D3stan/ecu-dev-board/emulator/docs/image.png

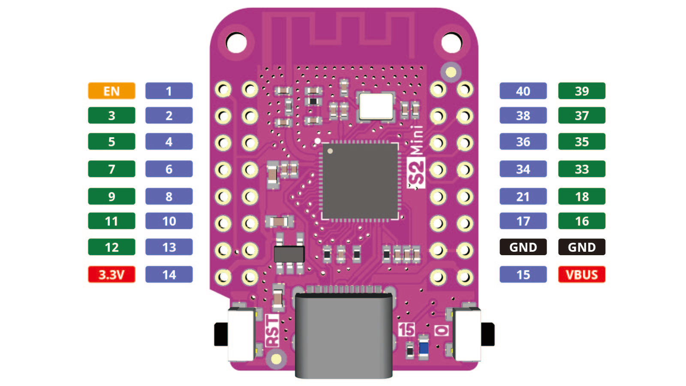
emulator/docs/image.png
