D3stan/ecu-dev-board/emulator/docs/architecture.md

# Simulator Node High-Level Architecture Prototyping

This document outlines the high-level architecture of the **ECU Simulator Node**. The simulator runs on a secondary ESP32 development board (e.g., standard ESP32 or ESP32-S2), serving as a hardware-in-the-loop (HIL) test-bench. It physicalizes mechanical and thermal signals (Pick-up coil sensor, Throttle Position Sensor, Exhaust Gas Temperature) and measures the resulting ECU CDI (Capacitor Discharge Ignition) trigger output to calculate spark advance.

## Design Philosophy: Centralized Configuration & Native ESP-IDF

To ensure sub-microsecond pulse timing accuracy, zero task-switching overhead, and maximal determinism in the kinematics calculations, **the core Simulator logic operates in a single-threaded superloop** paired with hardware interrupts and low-overhead timers. 

### Key Principles:
- **Centralized Pin Mappings**: All simulator inputs and outputs are defined as macros in a centralized `pins.h` header file, allowing easy hardware portability across ESP32 and ESP32-S2 development boards.
- **ESP-IDF Native Components**: Web interfaces and API endpoints are powered by ESP-IDF's native `esp_http_server` module, avoiding third-party Arduino dependencies and maintaining compliance with standard ESP-IDF workflows.
- **Analog Sensor Outputs**: EGT is generated with the on-chip DAC. On the LOLIN ESP32-S2 mini, TPS is generated with LEDC PWM on GPIO16 and an external RC low-pass filter because GPIO18/DAC_2 is pulled up on the board.
- **Open-Loop Signal Generation**: The pick-up coil pulse generator operates independently of the ECU's spark output, dynamically translating the selected RPM (from Web UI or potentiometer) to a corresponding frequency in Hz.
- **Passive Monitoring**: The spark advance capture system acts as a passive observer, measuring the phase relationship of the ECU's output relative to the generated pickup signal without feeding back into the signal generation logic.

---

## High-Level Architecture Overview

The simulator consists of three key architectural blocks cooperating in a single-threaded loop:

```mermaid
graph TD
    subgraph MCU Core [MCU Core & State Machine]
        Superloop[Superloop Main Timing Loop]
        EngineSim[Engine Kinematics & Thermal Simulator]
        Telemetry[JSON Frame Composer]
    end

    subgraph IO [I/O - Signal Generators & Capture]
        ADC_Read[ADC: Read TPS & EGT Potentiometers]
        PulseGen[Hardware Timer: Pick-up Pulse Generator]
        SparkCapture[GPIO Interrupt: Spark Timing Capture]
        QSButton[GPIO Poll: Physical QS Button]
    end

    subgraph WebUI [Simulator Web UI & API]
        HTTPServer[esp_http_server - Native Web & WS]
        OverrideMgr[Manual Override / Fault Injector]
    end

    Superloop -->|Run Periodic| EngineSim
    Superloop -->|Process Polls| ADC_Read
    EngineSim -->|Compute Target Freq| PulseGen
    SparkCapture -->|Record Spark Offset| EngineSim
    QSButton -->|Trigger QS Pulse| EngineSim
    HTTPServer -->|Inject Overrides| OverrideMgr
    OverrideMgr -->|Override Params| EngineSim
    EngineSim -->|State Payload| Telemetry
    Telemetry -->|Stream via Websockets| HTTPServer
```

---

## Important Subsystems

To keep the codebase modular and organized, the architecture is split into three main technical specifications:

### 1. [MCU Core (Engine Simulator)](file:///Users/puddu/Documents/GitHub/ecu-dev-board/idf/docs/sim/mcu_core.md)
Responsible for engine rotation kinematics, thermal rise/decay equations, virtual overrides, and telemetry compilation. It coordinates the overall logic of the simulation without spawning concurrent tasks.

### 2. [I/O Interface (Hardware Layer)](file:///Users/puddu/Documents/GitHub/ecu-dev-board/idf/docs/sim/io.md)
Responsible for physical interaction, using pin assignments defined in `pins.h`:
- **Generation**: Creating the pick-up sensor square wave based on the selected RPM using hardware LEDC.
- **Measurement**: Capturing the ECU's CDI spark output with a high-precision input capture GPIO interrupt.
- **Sampling**: Reading physical potentiometers using the ADC to simulate TPS and EGT sensors.

### 3. [Simulator Web UI (Interactive Panel)](file:///Users/puddu/Documents/GitHub/ecu-dev-board/idf/docs/sim/web_ui.md)
A lightweight web interface hosted directly on the simulator's flash filesystem. It allows developers to:
- Actively override analog sensor values (TPS, EGT) via virtual sliders.
- Artificially inject faults (e.g., EGT overheating) to test the ECU's `ALARM` state.
- Monitor physical spark timing metrics calculated by the capture system.

---

## HIL Hardware Connections

All pins listed below are configurable via `pins.h` to support various development boards (ESP32 / ESP32-S2):

| Simulator Pin Macro | ESP32-S2 / Lolin S2 Mini GPIO | Signal Type | Signal Description |
|---|---|---|---|
| `SIM_PIN_PICKUP` | **GPIO 13** | Output to ECU | Pick-up Coil Pulse (0-300 Hz square wave) |
| `SIM_PIN_TPS_OUT` | **GPIO 16** | Output to ECU | TPS PWM output; filter through 1k + 4.7uF before ECU TPS input |
| `SIM_PIN_EGT_OUT` | **GPIO 17** | Output to ECU | EGT Analog Voltage (0-3.3V via hardware DAC Channel 1) |
| `SIM_PIN_SPARK` | **GPIO 21** | Input from ECU | CDI Ignition Spark Trigger |
| `SIM_PIN_QS_OUT` | **GPIO 12** | Output to ECU | Quick-Shifter (QS) Switch Trigger (Active-Low pulse) |
| `SIM_PIN_QS_IN` | **GPIO 14** | Local input | Physical active-low QS button input; debounced in the fast superloop poll |
| `SIM_PIN_TPS_POT` | **GPIO 1** | Local analog input | Physical TPS potentiometer (ADC1_CH0) |
| `SIM_PIN_EGT_POT` | **GPIO 2** | Local analog input | Physical EGT potentiometer (ADC1_CH1) |
| **GND** | **GND** | Ground Share | Common Ground Reference |
