D3stan/ecu-dev-board/emulator/webui/doc/useComponents/InputTimer/INDEX.md

# 📁 InputTimer Component - Documentazione

Questo folder contiene tutta la documentazione e gli esempi d'uso per il componente **InputTimer**.

---

## 📂 Struttura

```
InputTimer/
├── INDEX.md           # Questo file (indice documentazione)
├── README.md          # Documentazione tecnica completa del componente
├── SETUP.md           # Guida setup e integrazione passo-passo
├── example.js         # 5 esempi pratici di utilizzo
└── func.test.js       # Unit tests per le funzioni di utilità
```

---

## 🚀 Quick Start

1. **Setup**: Leggi [`SETUP.md`](./SETUP.md) per la guida passo-passo
2. **Documentazione**: Consulta [`README.md`](./README.md) per l'API completa
3. **Esempi**: Vedi [`example.js`](./example.js) per 5 casi d'uso pratici
4. **Test**: Esegui [`func.test.js`](./func.test.js) per testare la logica

---

## 📦 File di Produzione

I file di produzione si trovano in:

```
src/
├── js/components/InputTimer/
│   ├── InputTimer.js    ✅ Componente (extends Component)
│   └── func.js          ✅ Logica di conversione/validazione
│
└── css/components/
    └── InputTimer.css   ✅ Stili responsive
```

**Nota**: Solo questi 3 file vengono inclusi nel build di Vite. La documentazione resta fuori da `src/`.

---

## 🎯 Stato Implementazione

✅ **Completato** (18 Ottobre 2025)

- [x] Componente InputTimer creato
- [x] Logica separata in func.js
- [x] CSS responsive mobile-first
- [x] Traduzioni i18n (5 lingue)
- [x] Integrato in TimerEditorPage
- [x] CSS incluso in index.html
- [x] Build Vite funzionante
- [x] Documentazione completa
- [x] Esempi d'uso
- [x] Unit tests

---

## 📖 Link Utili

- [API Completa](./README.md#-api)
- [Esempi d'uso](./example.js)
- [Setup Checklist](./SETUP.md#-checklist-finale)
- [Troubleshooting](./README.md#-troubleshooting)
- [Testing](./README.md#-testing-checklist)

---

**Versione**: 1.0.0  
**Autore**: FogExtra Team  
**Data**: 18 Ottobre 2025
