D3stan/ecu-dev-board/pcb/Enclosure.step

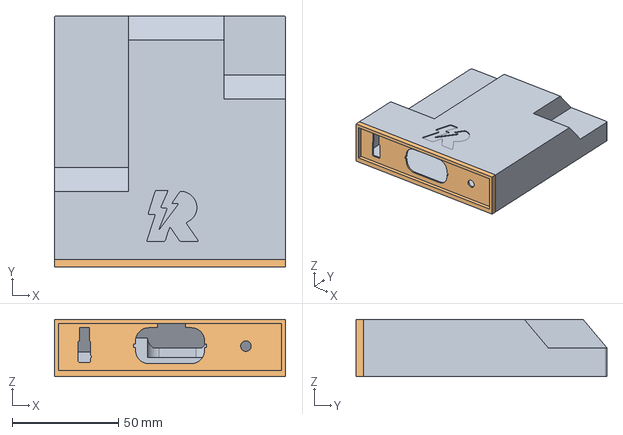
[picture p2: CAD file, 2025-12-03]
pcb/Enclosure.step
108.9 x 118.1 x 27.0 mm
