D3stan/ecu-dev-board/pcb/ecu-dev-board.kicad_pcb

## KiCad design pcb/ecu-dev-board.kicad_pcb (2025-10-15)

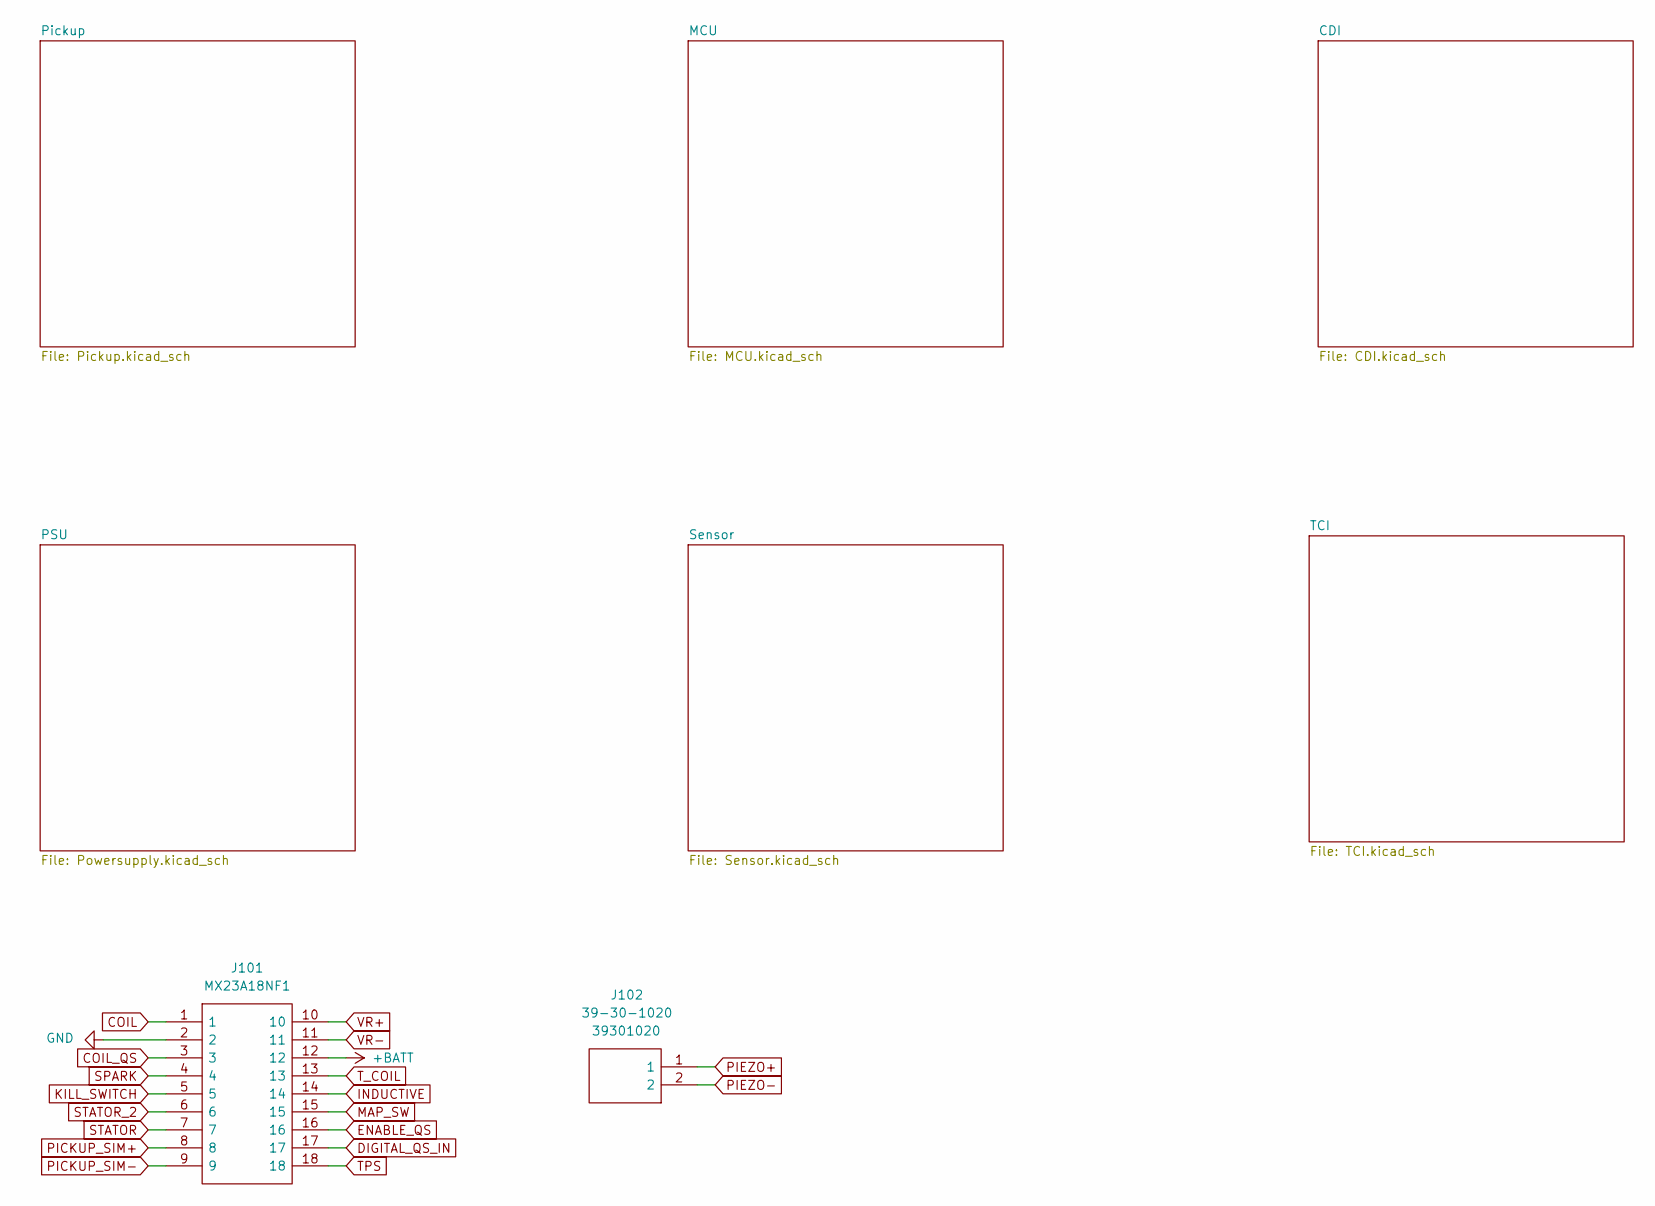
[picture p3: schematic ecu-dev-board.kicad_sch]

Parts:
J101: MX23A18NF1; Manufacturer_Part_Number MX23A18NF1; Mouser Part Number 656-MX23A18NF1
J102: 39-30-1020; Molex_Mini-Fit_Jr_5569-02A2_2x01_P4.20mm_Horizontal; Manufacturer_Part_Number 39301020; Mouser Part Number 538-39-30-1020

Connections:
+BATT: J101.12; also elsewhere on the board
COIL: J101.1; also elsewhere on the board
COIL_QS: J101.3; also elsewhere on the board
DIGITAL_QS_IN: J101.17; also elsewhere on the board
ENABLE_QS: J101.16; also elsewhere on the board
INDUCTIVE: J101.14; also elsewhere on the board
KILL_SWITCH: J101.5; also elsewhere on the board
MAP_SW: J101.15; also elsewhere on the board
PICKUP_SIM+: J101.8; also elsewhere on the board
PICKUP_SIM-: J101.9; also elsewhere on the board
PIEZO+: J102.1; also elsewhere on the board
PIEZO-: J102.2; also elsewhere on the board
SPARK: J101.4; also elsewhere on the board
STATOR: J101.7; also elsewhere on the board
STATOR_2: J101.6; also elsewhere on the board
TPS: J101.18; also elsewhere on the board
T_COIL: J101.13; also elsewhere on the board
VR+: J101.10; also elsewhere on the board
VR-: J101.11; also elsewhere on the board

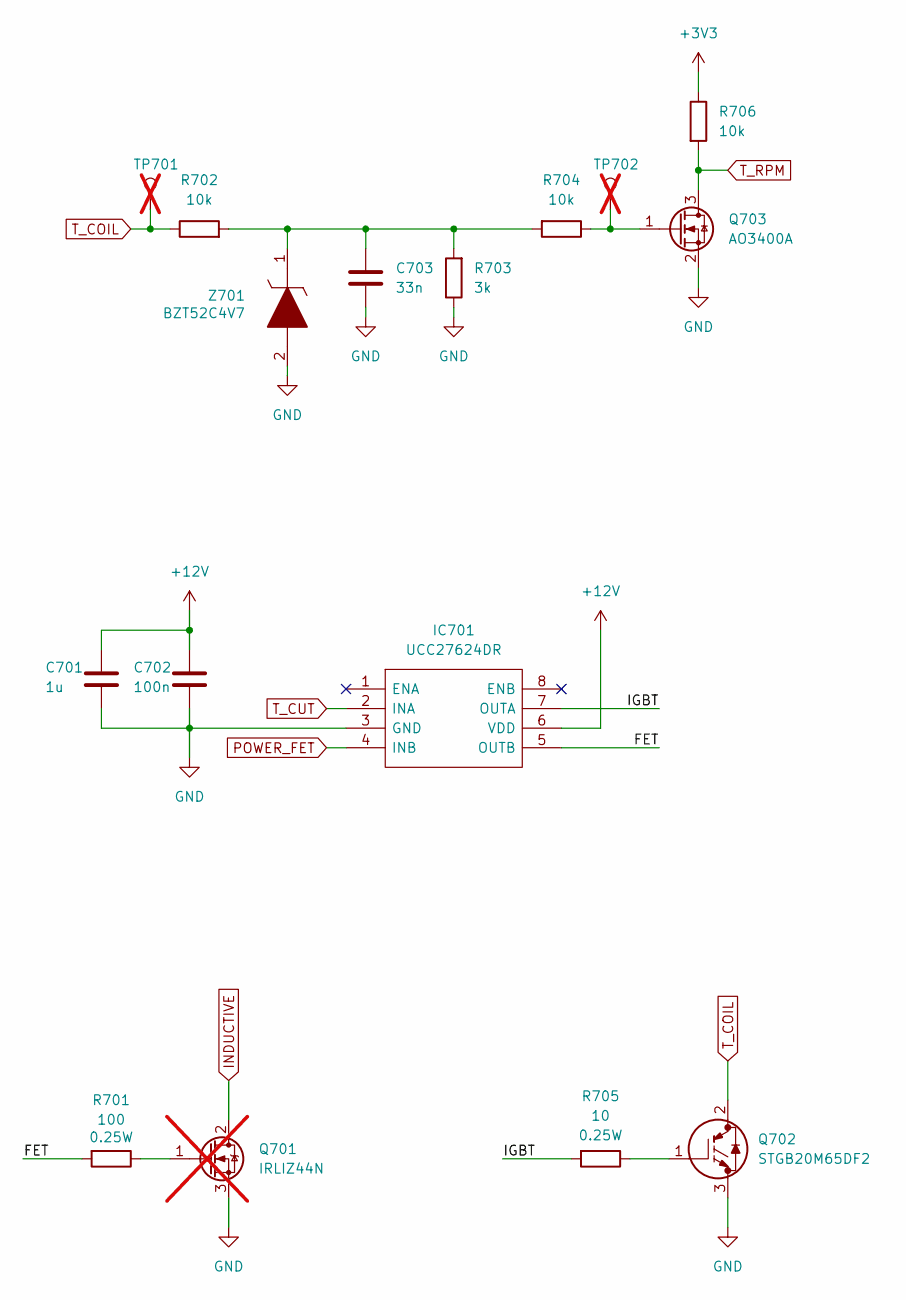
[picture p4: schematic TCI.kicad_sch]

Parts:
C701: 1u; C_0805_2012Metric
C702: 100n; C_0805_2012Metric
C703: 33n; C_0805_2012Metric
IC701: UCC27624DR; SOIC127P600X175-8N; Manufacturer_Part_Number UCC27624QDRQ1; Mouser Part Number 595-UCC27624QDRQ1
Q701: IRLIZ44N; TO-220F-3_Vertical; not fitted
Q702: STGB20M65DF2; TO-263-2; Manufacturer_Part_Number STGB20M65DF2; Mouser Part Number 511-STGB20M65DF2
Q703: AO3400A; SOT-23
R701: 100; R_0805_2012Metric
R702, R704, R706: 10k; R_0805_2012Metric
R703: 3k; R_0805_2012Metric
R705: 10; R_0805_2012Metric
TP701, TP702: TestPoint; PinHeader_1x01_P2.54mm_Vertical; not fitted
Z701: BZT52C4V7; D_SOD-123; Manufacturer_Part_Number BZT52B5V1-E3-08; Mouser Part Number 78-BZT52B5V1-E3-08

Connections:
+3V3: R706.1; also elsewhere on the board
+12V: C701.1, C702.1, IC701.6 (VDD); also elsewhere on the board
/TCI/FET: IC701.5 (OUTB), R701.2
/TCI/IGBT: IC701.7 (OUTA), R705.2
INDUCTIVE: Q701.2 (D); also elsewhere on the board
unnamed: C703.1, R702.2, R703.2, R704.2, Z701.1
unnamed: Q701.1 (G), R701.1
unnamed: Q702.1, R705.1
unnamed: Q703.1 (G), R704.1, TP702.1
POWER_FET: IC701.4 (INB); also elsewhere on the board
T_COIL: Q702.2, R702.1, TP701.1; also elsewhere on the board
T_CUT: IC701.2 (INA); also elsewhere on the board
T_RPM: Q703.3 (D), R706.2; also elsewhere on the board

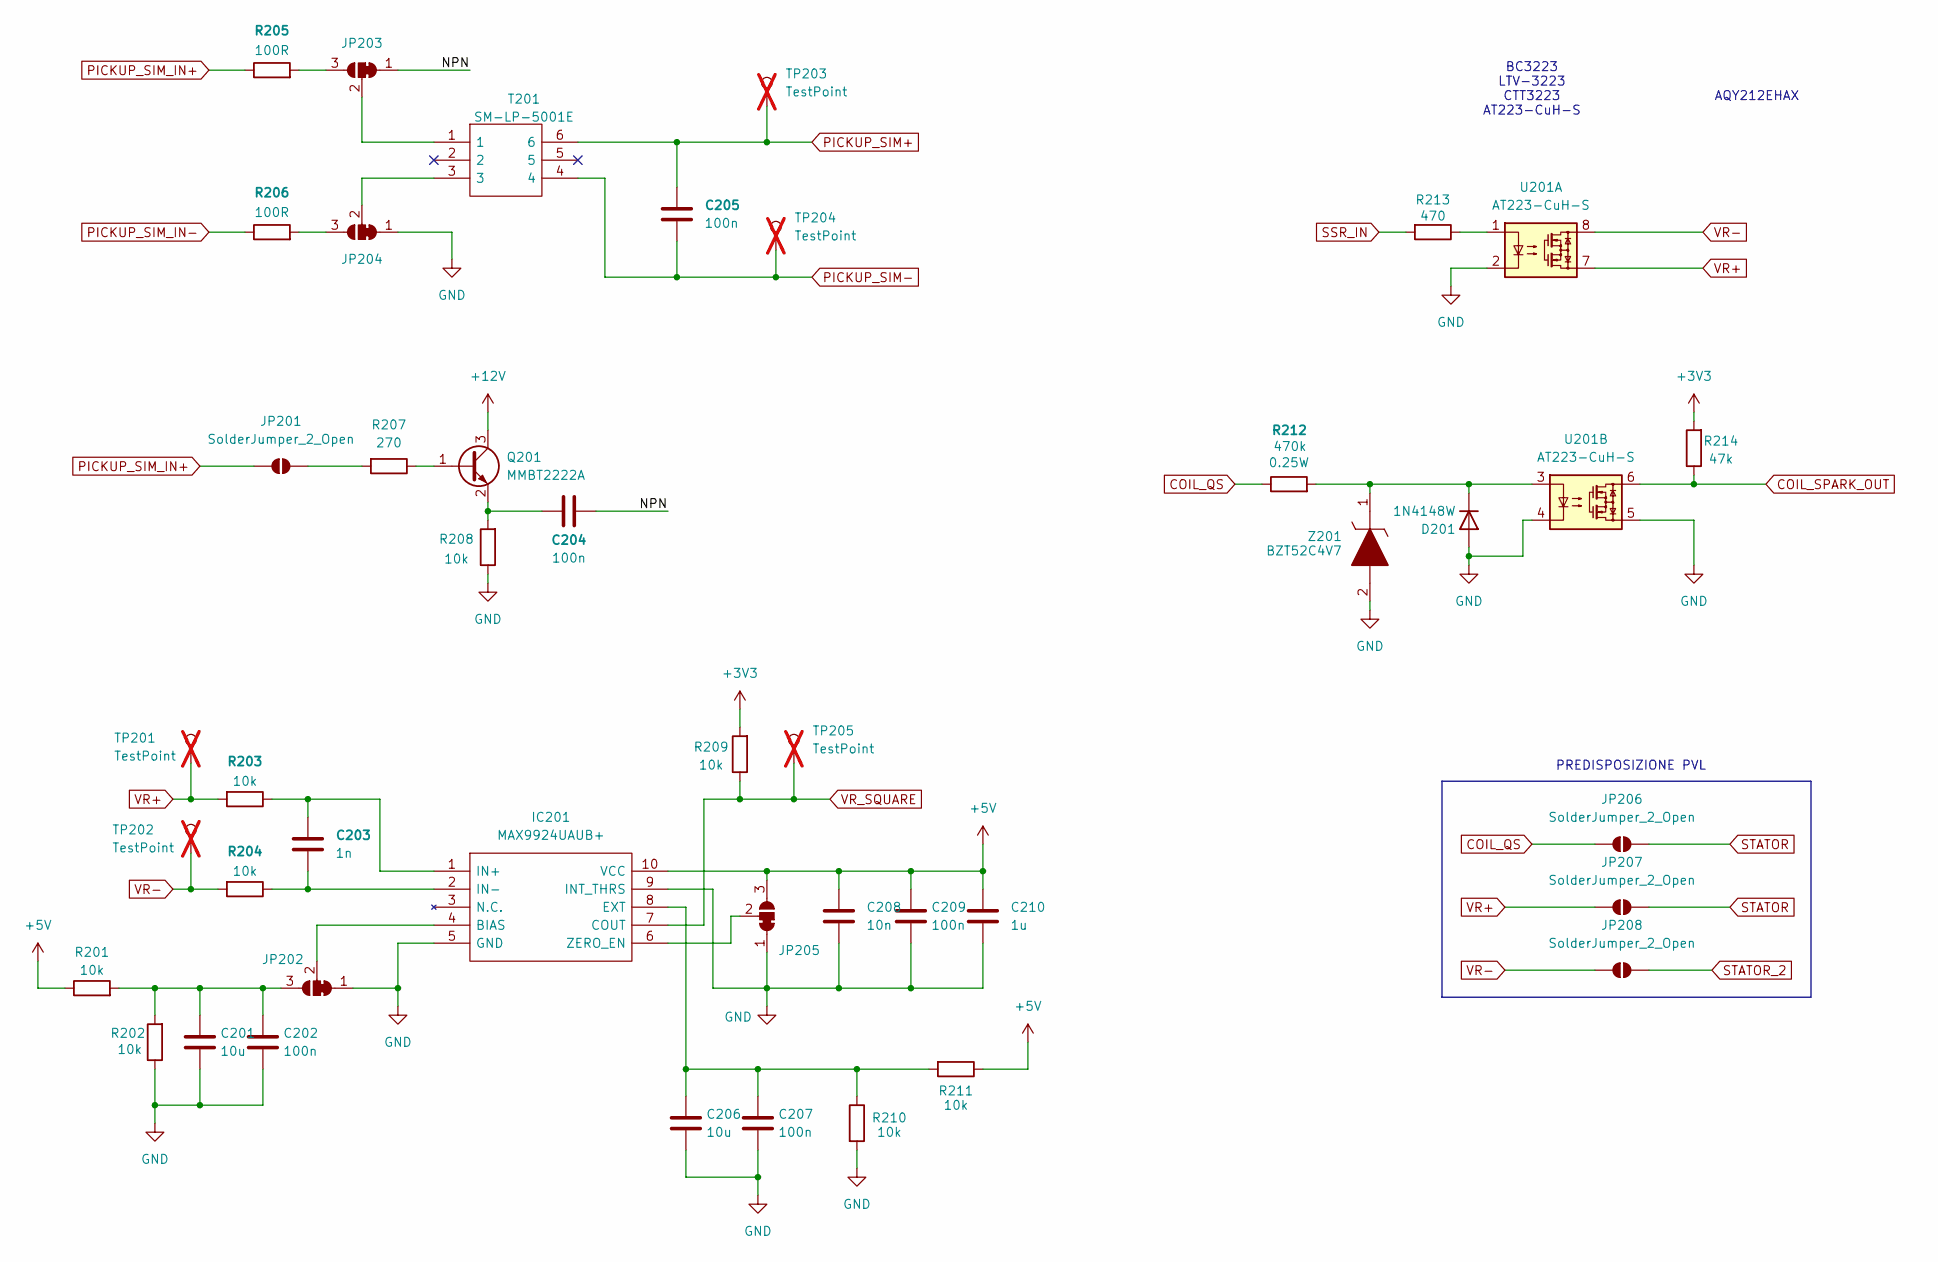
[picture p5: schematic Pickup.kicad_sch]

Parts:
C201, C206: 10u; C_0805_2012Metric
C202, C204, C205, C207, C209: 100n; C_0805_2012Metric
C203: 1n; C_0805_2012Metric
C208: 10n; C_0805_2012Metric
C210: 1u; C_0805_2012Metric
D201: 1N4148W; D_SOD-123
IC201: MAX9924UAUB+; SOP50P490X110-10N; Manufacturer_Part_Number MAX9924UAUB+; Mouser Part Number 700-MAX9924UAUB
JP201, JP206, JP207, JP208: SolderJumper_2_Open; SolderJumper-2_P1.3mm_Open_RoundedPad1.0x1.5mm
JP202, JP203, JP204, JP205: SolderJumper_3_Bridged12; SolderJumper-3_P1.3mm_Bridged2Bar12_RoundedPad1.0x1.5mm
Q201: MMBT2222A; SOT-23
R201, R202, R203, R204, R208, R209, R210, R211: 10k; R_0805_2012Metric
R205, R206: 100R; R_0805_2012Metric
R207: 270; R_0603_1608Metric
R212: 470k; R_0805_2012Metric
R213: 470; R_0805_2012Metric
R214: 47k; R_0805_2012Metric
T201: SM-LP-5001E; SMLP5001E; Manufacturer_Part_Number SM-LP-5001E; Mouser Part Number 652-SM-LP-5001E
TP201, TP202, TP203, TP204, TP205: TestPoint; PinHeader_1x01_P2.54mm_Vertical; not fitted
U201: AT223-CuH-S; SOP-8_6.605x9.655mm_P2.54mm
Z201: BZT52C4V7; D_SOD-123; Manufacturer_Part_Number BZT52B5V1-E3-08; Mouser Part Number 78-BZT52B5V1-E3-08

Connections:
+3V3: R209.2, R214.2; also elsewhere on the board
+5V: C208.1, C209.1, C210.1, IC201.10 (VCC), JP205.3 (B), R201.1, R211.1; also elsewhere on the board
+12V: Q201.3 (C); also elsewhere on the board
/Pickup/NPN: C204.1, JP203.1 (A)
COIL_QS: JP206.2 (B), R212.1; also elsewhere on the board
COIL_SPARK_OUT: R214.1, U201.6; also elsewhere on the board
unnamed: D201.1 (K), R212.2, U201.3, Z201.1
unnamed: IC201.4 (BIAS), JP202.2 (C)
unnamed: C206.1, C207.1, IC201.8 (EXT), R210.1, R211.2
unnamed: C203.1, IC201.1 (IN+), R203.1
unnamed: C203.2, IC201.2 (IN-), R204.1
unnamed: IC201.6 (ZERO_EN), JP205.2 (C)
unnamed: JP201.1 (A), R207.2
unnamed: C201.1, C202.1, JP202.3 (B), R201.2, R202.2
unnamed: JP203.3 (B), R205.2
unnamed: JP203.2 (C), T201.1
unnamed: JP204.3 (B), R206.2
unnamed: JP204.2 (C), T201.3
unnamed: Q201.1 (B), R207.1
unnamed: C204.2, Q201.2 (E), R208.2
unnamed: R213.1, U201.1
PICKUP_SIM+: C205.1, T201.6, TP203.1; also elsewhere on the board
PICKUP_SIM-: C205.2, T201.4, TP204.1; also elsewhere on the board
PICKUP_SIM_IN+: JP201.2 (B), R205.1; also elsewhere on the board
PICKUP_SIM_IN-: R206.1; also elsewhere on the board
SSR_IN: R213.2; also elsewhere on the board
STATOR: JP206.1 (A), JP207.1 (A); also elsewhere on the board
STATOR_2: JP208.1 (A); also elsewhere on the board
VR+: JP207.2 (B), R203.2, TP201.1, U201.7; also elsewhere on the board
VR-: JP208.2 (B), R204.2, TP202.1, U201.8; also elsewhere on the board
VR_SQUARE: IC201.7 (COUT), R209.1, TP205.1; also elsewhere on the board

Notes on the sheet:
BC3223 LTV-3223 CTT3223 AT223-CuH-S
PREDISPOSIZIONE PVL
AQY212EHAX

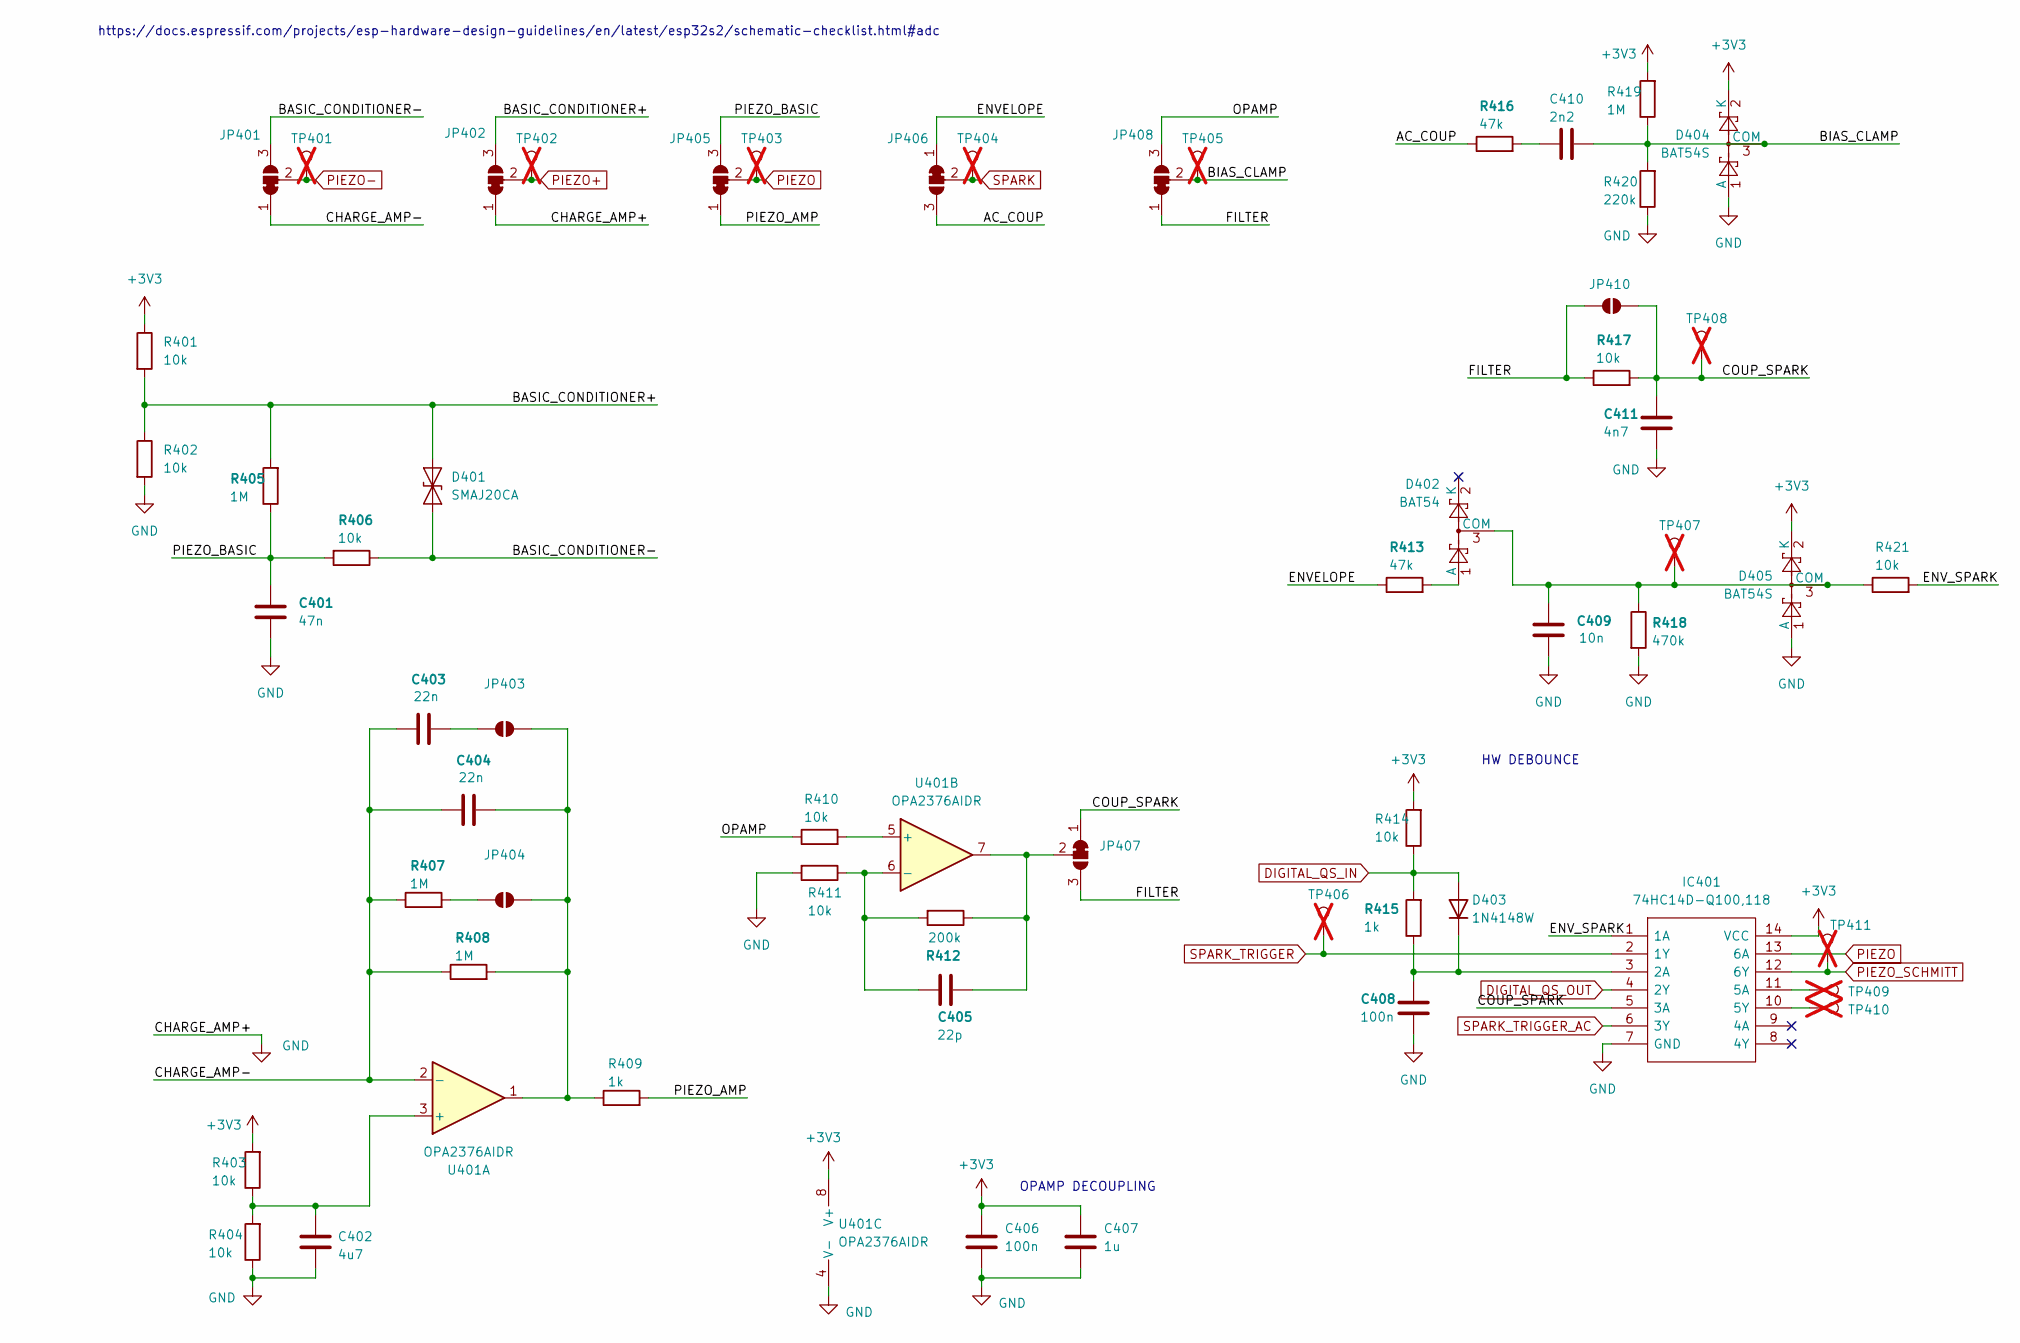
[picture p6: schematic Sensor.kicad_sch]

Parts:
C401: 47n; C_0805_2012Metric
C402: 4u7; C_0805_2012Metric
C403, C404: 22n; C_0805_2012Metric
C405: 22p; C_0805_2012Metric
C406, C408: 100n; C_0805_2012Metric
C407: 1u; C_0805_2012Metric
C409: 10n; C_0805_2012Metric
C410: 2n2; C_0805_2012Metric
C411: 4n7; C_0805_2012Metric
D401: SMAJ20CA; D_SMA
D402: BAT54; SOT-23
D403: 1N4148W; D_SOD-123
D404, D405: BAT54S; SOT-23
IC401: 74HC14D-Q100,118; SOIC127P600X175-14N; Manufacturer_Part_Number 74HC14D-Q100,118; Mouser Part Number 771-74HC14D-Q100
JP401, JP402, JP405, JP406, JP407, JP408: SolderJumper_3_Bridged12; SolderJumper-3_P1.3mm_Bridged2Bar12_RoundedPad1.0x1.5mm
JP403, JP404, JP410: SolderJumper_2_Open; SolderJumper-2_P1.3mm_Open_RoundedPad1.0x1.5mm
R401, R402, R403, R404, R406, R410, R411, R414, R417, R421: 10k; R_0805_2012Metric
R405, R407, R408, R419: 1M; R_0805_2012Metric
R409, R415: 1k; R_0805_2012Metric
R412: 200k; R_0805_2012Metric
R413, R416: 47k; R_0805_2012Metric
R418: 470k; R_0805_2012Metric
R420: 220k; R_0805_2012Metric
TP401, TP402, TP403, TP404, TP405, TP406, TP407, TP408, TP409, TP410, TP411: TestPoint; PinHeader_1x01_P2.54mm_Vertical; not fitted
U401: OPA2376AIDR; SOIC127P600X175-8N

Connections:
+3V3: C406.1, C407.1, D404.2 (K), D405.2 (K), IC401.14 (VCC), R401.1, R403.2, R414.2, R419.2, U401.8 (V+); also elsewhere on the board
/Sensor/AC_COUP: JP406.3 (B), R416.1
/Sensor/BASIC_CONDITIONER+: D401.2 (A2), JP402.3 (B), R401.2, R402.1, R405.2
/Sensor/BASIC_CONDITIONER-: D401.1 (A1), JP401.3 (B), R406.1
/Sensor/BIAS_CLAMP: C410.2, D404.3 (COM), JP408.2 (C), R419.1, R420.2, TP405.1
/Sensor/CHARGE_AMP-: C403.1, C404.1, JP401.1 (A), R407.1, R408.1, U401.2 (-)
/Sensor/COUP_SPARK: C411.2, IC401.5 (3A), JP407.1 (A), JP410.1 (A), R417.2, TP408.1
/Sensor/ENVELOPE: JP406.1 (A), R413.1
/Sensor/ENV_SPARK: IC401.1 (1A), R421.2
/Sensor/FILTER: JP407.3 (B), JP408.1 (A), JP410.2 (B), R417.1
/Sensor/OPAMP: JP408.3 (B), R410.1
/Sensor/PIEZO_AMP: JP405.1 (A), R409.2
/Sensor/PIEZO_BASIC: C401.1, JP405.3 (B), R405.1, R406.2
DIGITAL_QS_IN: D403.2 (A), R414.1, R415.2; also elsewhere on the board
DIGITAL_QS_OUT: IC401.4 (2Y); also elsewhere on the board
unnamed: C410.1, R416.2
unnamed: D402.1 (A), R413.2
unnamed: C409.1, D402.3 (COM), D405.3 (COM), R418.1, R421.1, TP407.1
unnamed: C408.2, D403.1 (K), IC401.3 (2A), R415.1
unnamed: IC401.11 (5A), TP409.1
unnamed: IC401.10 (5Y), TP410.1
unnamed: C404.2, JP403.1 (A), JP404.1 (A), R408.2, R409.1, U401.1
unnamed: C403.2, JP403.2 (B)
unnamed: JP404.2 (B), R407.2
unnamed: C405.1, JP407.2 (C), R412.1, U401.7
unnamed: C402.1, R403.1, R404.2, U401.3 (+)
unnamed: R410.2, U401.5 (+)
unnamed: C405.2, R411.1, R412.2, U401.6 (-)
PIEZO: IC401.13 (6A), JP405.2 (C), TP403.1; also elsewhere on the board
PIEZO+: JP402.2 (C), TP402.1; also elsewhere on the board
PIEZO-: JP401.2 (C), TP401.1; also elsewhere on the board
PIEZO_SCHMITT: IC401.12 (6Y), TP411.1; also elsewhere on the board
SPARK: JP406.2 (C), TP404.1; also elsewhere on the board
SPARK_TRIGGER: IC401.2 (1Y), TP406.1; also elsewhere on the board
SPARK_TRIGGER_AC: IC401.6 (3Y); also elsewhere on the board

Notes on the sheet:
HW DEBOUNCE
OPAMP DECOUPLING
https://docs.espressif.com/projects/esp-hardware-design-guidelines/en/latest/esp32s2/schematic-checklist.html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

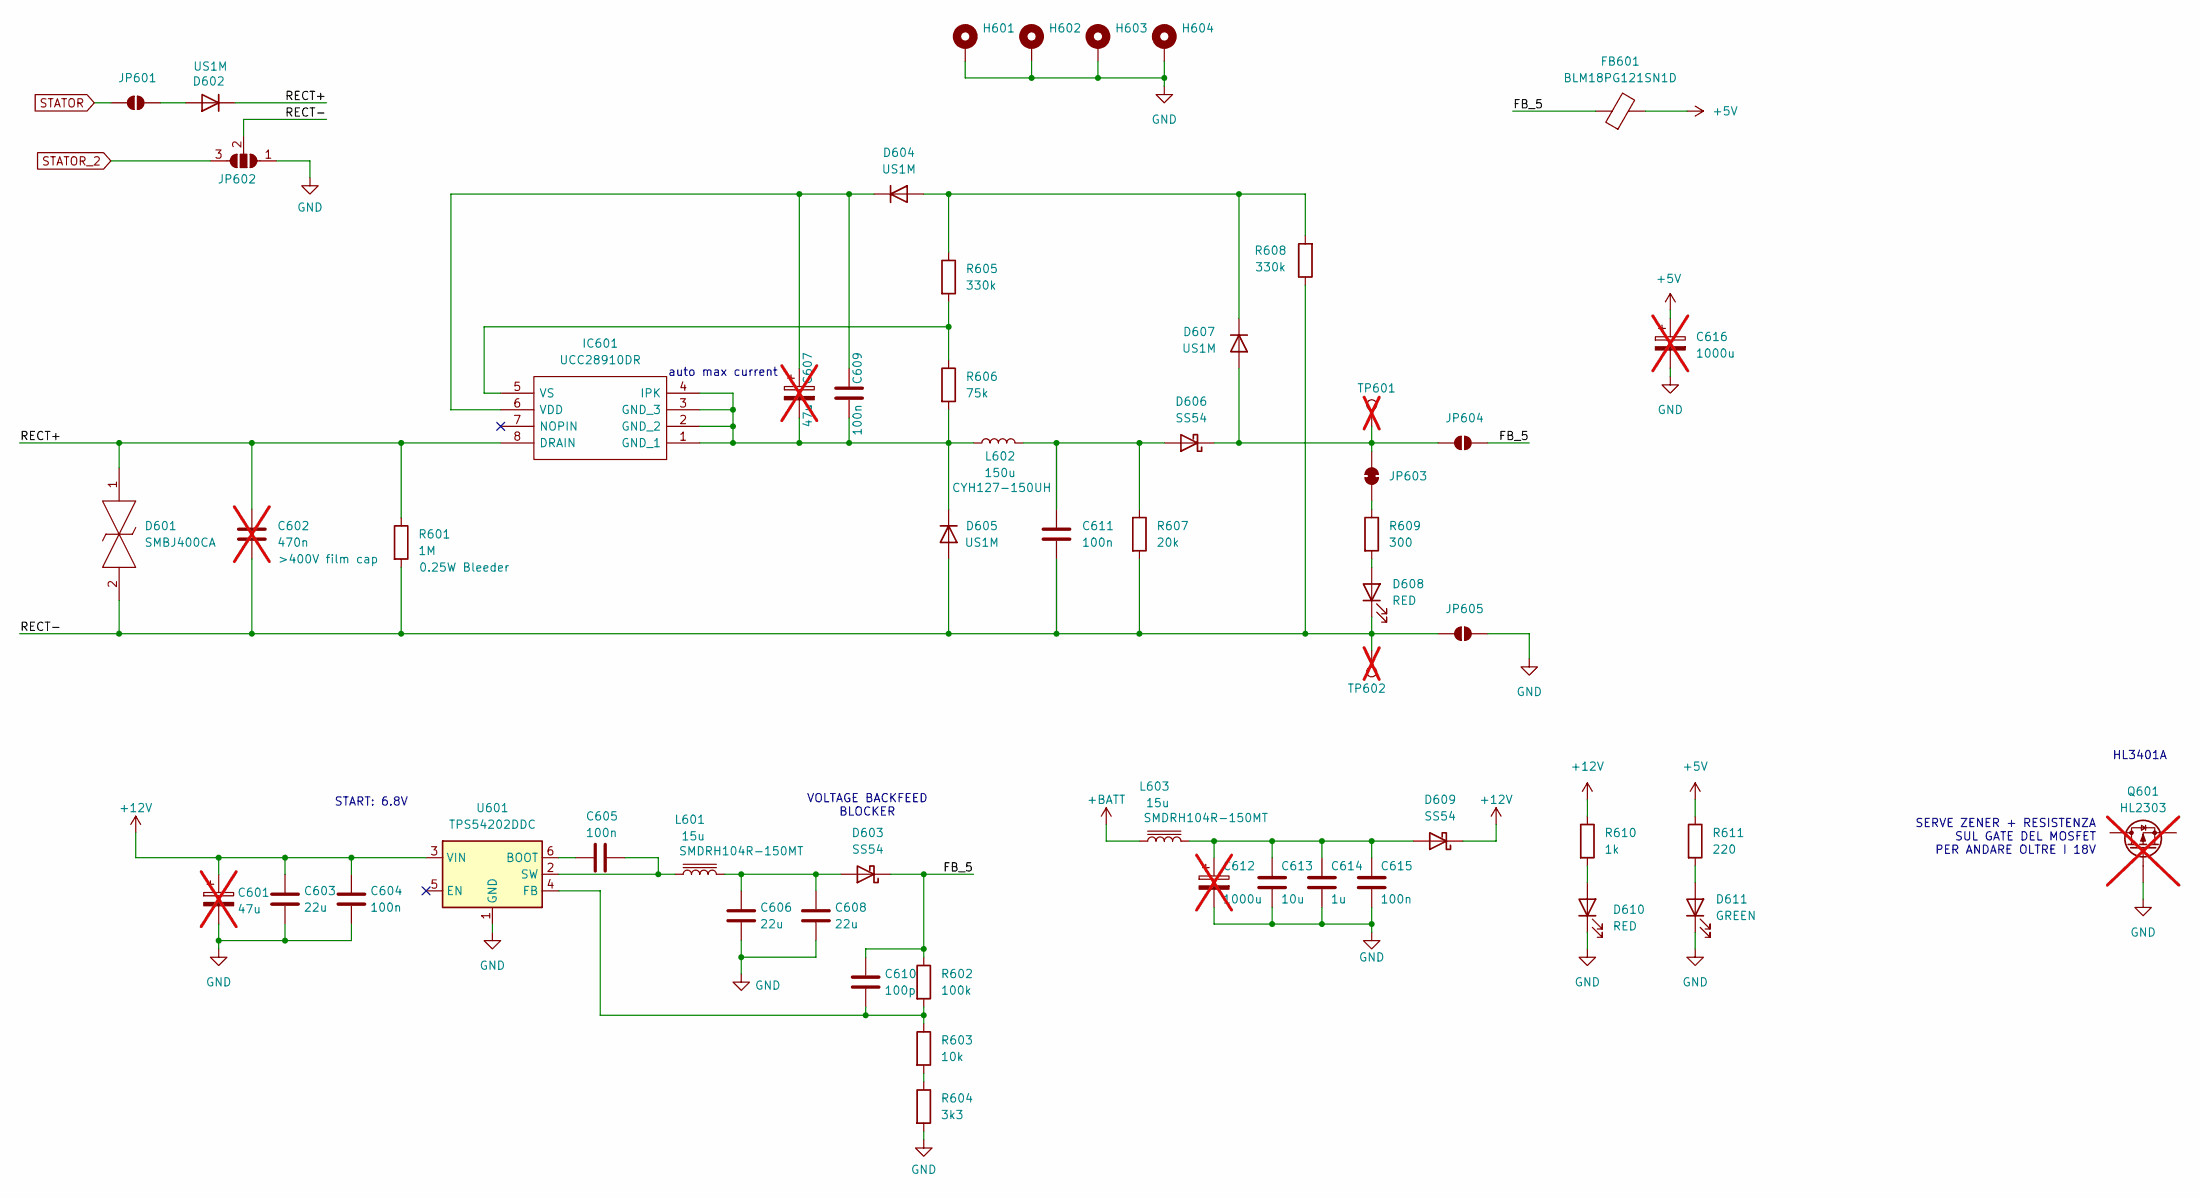
[picture p7: schematic Powersupply.kicad_sch]

Parts:
C601, C607: 47u; CP_Radial_D5.0mm_P2.50mm; not fitted
C602: 470n; C_Rect_L7.0mm_W2.0mm_P5.00mm; not fitted
C603, C606, C608: 22u; C_0805_2012Metric
C604, C605, C609, C611, C615: 100n; C_0805_2012Metric
C610: 100p; C_0603_1608Metric
C612, C616: 1000u; CP_Radial_D8.0mm_P5.00mm; not fitted
C613: 10u; C_0805_2012Metric
C614: 1u; C_0805_2012Metric
D601: SMBJ400CA; DIONM5436X261N; Manufacturer_Part_Number SMBJ400CA; Mouser Part Number 576-SMBJ400CA
D602, D604, D605, D607: US1M; D_SMA
D603, D606, D609: SS54; D_SMA
D608, D610: RED; LED_0805_2012Metric
D611: GREEN; LED_0805_2012Metric
FB601: BLM18PG121SN1D; L_0603_1608Metric
H601, H602, H603, H604: MountingHole_Pad; MountingHole_3.2mm_M3_DIN965_Pad
IC601: UCC28910DR; SOIC127P600X175-8N; Manufacturer_Part_Number UCC28910DR; Mouser Part Number 595-UCC28910DR
JP601, JP604, JP605: SolderJumper_2_Open; SolderJumper-2_P1.3mm_Open_RoundedPad1.0x1.5mm
JP602: SolderJumper_3_Open; SolderJumper-3_P1.3mm_Open_RoundedPad1.0x1.5mm
JP603: SolderJumper_2_Bridged; SolderJumper-2_P1.3mm_Bridged_RoundedPad1.0x1.5mm
L601, L603: 15u; L_10.4x10.4_H4.8
L602: 150u; L_SXN_SMDRI127
Q601: HL2303; SOT-23; not fitted
R601: 1M; R_0805_2012Metric
R602: 100k; R_0805_2012Metric
R603: 10k; R_0805_2012Metric
R604: 3k3; R_0805_2012Metric
R605, R608: 330k; R_0603_1608Metric
R606: 75k; R_0603_1608Metric
R607: 20k; R_0805_2012Metric
R609: 300; R_0805_2012Metric
R610: 1k; R_0805_2012Metric
R611: 220; R_0805_2012Metric
TP601, TP602: TestPoint; PinHeader_1x01_P2.54mm_Vertical; not fitted
U601: TPS54202DDC; SOT-23-6

Connections:
+5V: C616.1, FB601.2, R611.1; also elsewhere on the board
+12V: C601.1, C603.1, C604.1, D609.1 (K), R610.1, U601.3 (VIN); also elsewhere on the board
+BATT: L603.1; also elsewhere on the board
/PSU/FB_5: C610.1, D603.1 (K), FB601.1, JP604.2 (B), R602.1
/PSU/RECT+: C602.1, D601.1, D602.1 (K), IC601.8 (DRAIN), R601.1
/PSU/RECT-: C602.2, C611.2, D601.2, D605.2 (A), D608.1 (K), JP602.2 (C), JP605.1 (A), R601.2, R607.2, R608.1, TP602.1
unnamed: D602.2 (A), JP601.2 (B)
unnamed: C606.1, C608.1, D603.2 (A), L601.2
unnamed: D604.2 (A), D607.1 (K), R605.1, R608.2
unnamed: C607.1, C609.1, D604.1 (K), IC601.6 (VDD)
unnamed: C607.2, C609.2, D605.1 (K), IC601.1 (GND_1), IC601.2 (GND_2), IC601.3 (GND_3), IC601.4 (IPK), L602.1, R606.2
unnamed: C611.1, D606.2 (A), L602.2, R607.1
unnamed: D606.1 (K), D607.2 (A), JP603.2 (B), JP604.1 (A), TP601.1
unnamed: D608.2 (A), R609.2
unnamed: C612.1, C613.1, C614.1, C615.1, D609.2 (A), L603.2
unnamed: D610.2 (A), R610.2
unnamed: D611.2 (A), R611.2
unnamed: IC601.5 (VS), R605.2, R606.1
unnamed: JP603.1 (A), R609.1
unnamed: R603.2, R604.1
unnamed: C605.1, U601.6 (BOOT)
unnamed: C610.2, R602.2, R603.1, U601.4 (FB)
unnamed: C605.2, L601.1, U601.2 (SW)
STATOR: JP601.1 (A); also elsewhere on the board
STATOR_2: JP602.3 (B); also elsewhere on the board

Notes on the sheet:
START: 6.8V
auto max current
HL3401A
VOLTAGE BACKFEED BLOCKER
SERVE ZENER + RESISTENZA SUL GATE DEL MOSFET PER ANDARE OLTRE I 18V

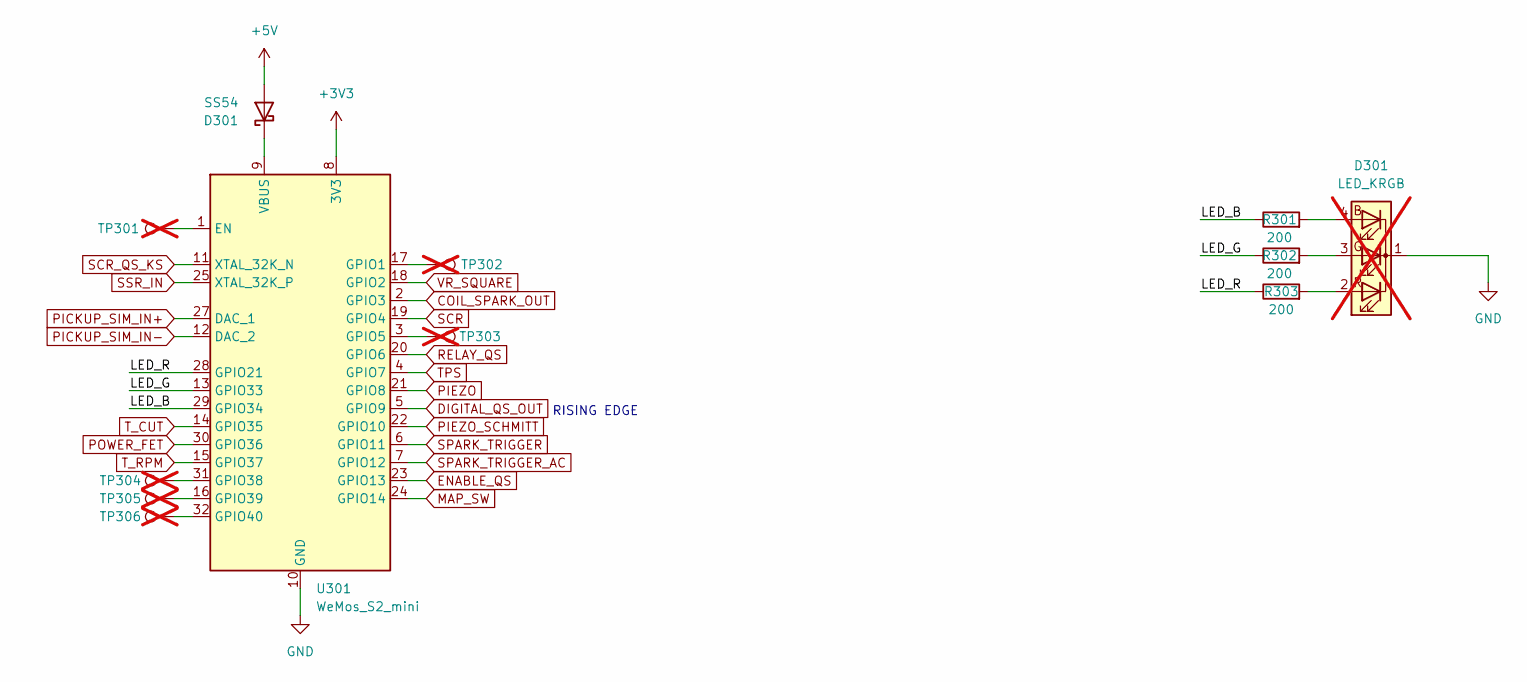
[picture p8: schematic MCU.kicad_sch]

Parts:
D301: LED_KRGB; LED_D5.0mm-4_RGB_Wide_Pins; not fitted
R301, R302, R303: 200; R_0805_2012Metric
TP301, TP302, TP303, TP304, TP305, TP306: TestPoint; PinHeader_1x01_P2.54mm_Vertical; not fitted
U301: WeMos_S2_mini; WEMOS_S2_mini

Connections:
+3V3: U301.8 (3V3); also elsewhere on the board
/MCU/LED_B: R301.1, U301.29 (GPIO34)
/MCU/LED_G: R302.1, U301.13 (GPIO33)
/MCU/LED_R: R303.1, U301.28 (GPIO21)
COIL_SPARK_OUT: U301.2 (GPIO3); also elsewhere on the board
DIGITAL_QS_OUT: U301.5 (GPIO9); also elsewhere on the board
ENABLE_QS: U301.23 (GPIO13); also elsewhere on the board
MAP_SW: U301.24 (GPIO14); also elsewhere on the board
unnamed: D301.4 (BA), R301.2
unnamed: D301.3 (GA), R302.2
unnamed: D301.2 (RA), R303.2
unnamed: TP301.1, U301.1 (EN)
unnamed: TP302.1, U301.17 (GPIO1)
unnamed: TP303.1, U301.3 (GPIO5)
unnamed: TP304.1, U301.31 (GPIO38)
unnamed: TP305.1, U301.16 (GPIO39)
unnamed: TP306.1, U301.32 (GPIO40)
PICKUP_SIM_IN+: U301.27 (DAC_1); also elsewhere on the board
PICKUP_SIM_IN-: U301.12 (DAC_2); also elsewhere on the board
PIEZO: U301.21 (GPIO8); also elsewhere on the board
PIEZO_SCHMITT: U301.22 (GPIO10); also elsewhere on the board
POWER_FET: U301.30 (GPIO36); also elsewhere on the board
RELAY_QS: U301.20 (GPIO6); also elsewhere on the board
SCR: U301.19 (GPIO4); also elsewhere on the board
SCR_QS_KS: U301.11 (XTAL_32K_N); also elsewhere on the board
SPARK_TRIGGER: U301.6 (GPIO11); also elsewhere on the board
SPARK_TRIGGER_AC: U301.7 (GPIO12); also elsewhere on the board
SSR_IN: U301.25 (XTAL_32K_P); also elsewhere on the board
TPS: U301.4 (GPIO7); also elsewhere on the board
T_CUT: U301.14 (GPIO35); also elsewhere on the board
T_RPM: U301.15 (GPIO37); also elsewhere on the board
VR_SQUARE: U301.18 (GPIO2); also elsewhere on the board

Notes on the sheet:
RISING EDGE

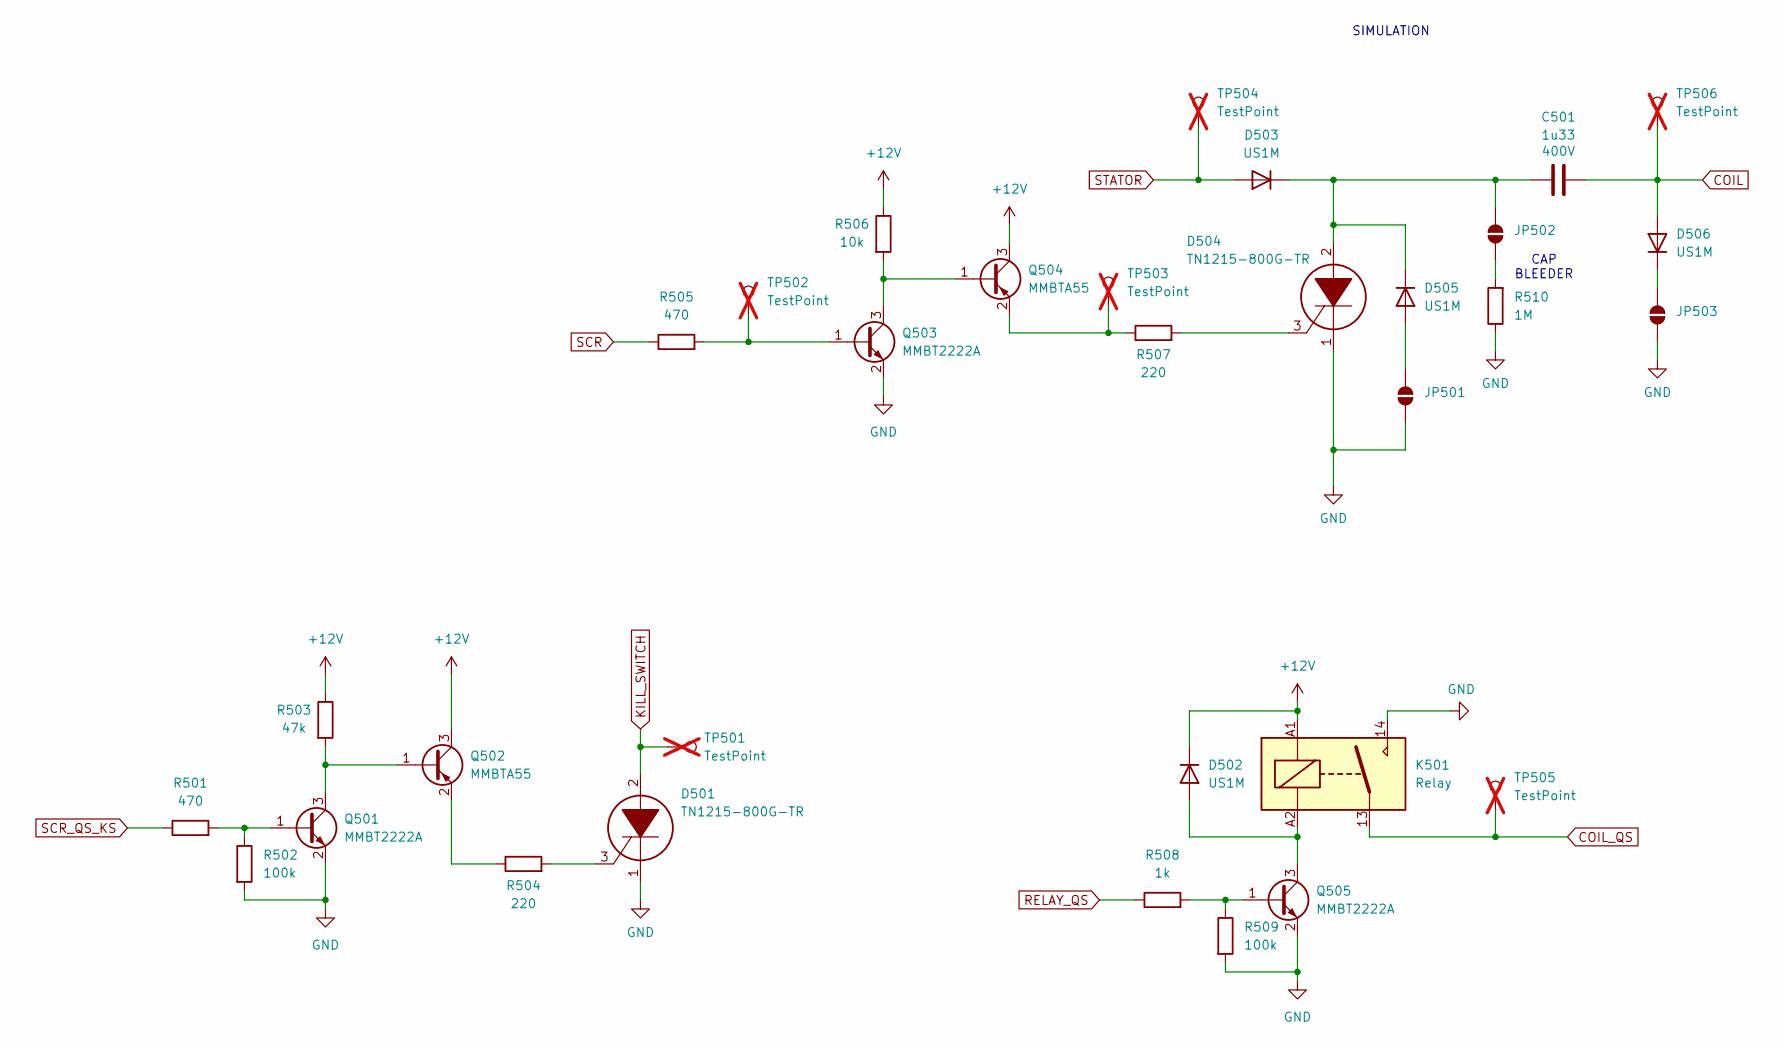
[picture p9: schematic CDI.kicad_sch]

Parts:
C501: 1u33; C_Axial_L17.0mm_D6.5mm_P20.00mm_Horizontal
D501, D504: TN1215-800G-TR; TO-263-2; Manufacturer_Part_Number TN1215-800G-TR; Mouser Part Number 511-TN1215-800G-TR
D502, D503, D505, D506: US1M; D_SMA
JP501, JP502, JP503: SolderJumper_2_Open; SolderJumper-2_P1.3mm_Open_RoundedPad1.0x1.5mm
K501: Relay; Ext_Relay
Q501, Q503, Q505: MMBT2222A; SOT-23
Q502, Q504: MMBTA55; SOT-23
R501, R505: 470; R_0805_2012Metric
R502, R509: 100k; R_0805_2012Metric
R503: 47k; R_0805_2012Metric
R504, R507: 220; R_0805_2012Metric
R506: 10k; R_0805_2012Metric
R508: 1k; R_0805_2012Metric
R510: 1M; R_0805_2012Metric
TP501, TP502, TP503, TP504, TP505, TP506: TestPoint; PinHeader_1x01_P2.54mm_Vertical; not fitted

Connections:
+12V: D502.1 (K), K501.A1, Q502.3 (C), Q504.3 (C), R503.1, R506.1; also elsewhere on the board
COIL: C501.2, D506.2 (A), TP506.1; also elsewhere on the board
COIL_QS: K501.13, TP505.1; also elsewhere on the board
KILL_SWITCH: D501.2, TP501.1; also elsewhere on the board
unnamed: D501.3, R504.2
unnamed: D502.2 (A), K501.A2, Q505.3 (C)
unnamed: C501.1, D503.1 (K), D504.2, D505.1 (K), JP502.2 (B)
unnamed: D504.3, R507.2
unnamed: D505.2 (A), JP501.2 (B)
unnamed: D506.1 (K), JP503.2 (B)
unnamed: JP502.1 (A), R510.2
unnamed: Q501.1 (B), R501.2, R502.1
unnamed: Q501.3 (C), Q502.1 (B), R503.2
unnamed: Q502.2 (E), R504.1
unnamed: Q503.1 (B), R505.2, TP502.1
unnamed: Q503.3 (C), Q504.1 (B), R506.2
unnamed: Q504.2 (E), R507.1, TP503.1
unnamed: Q505.1 (B), R508.2, R509.1
RELAY_QS: R508.1; also elsewhere on the board
SCR: R505.1; also elsewhere on the board
SCR_QS_KS: R501.1; also elsewhere on the board
STATOR: D503.2 (A), TP504.1; also elsewhere on the board

Notes on the sheet:
SIMULATION
CAP BLEEDER

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
