D3stan/ecu-dev-board/pcb/ecu-dev-board.kicad_pcb

## KiCad design pcb/ecu-dev-board.kicad_pcb (continued)

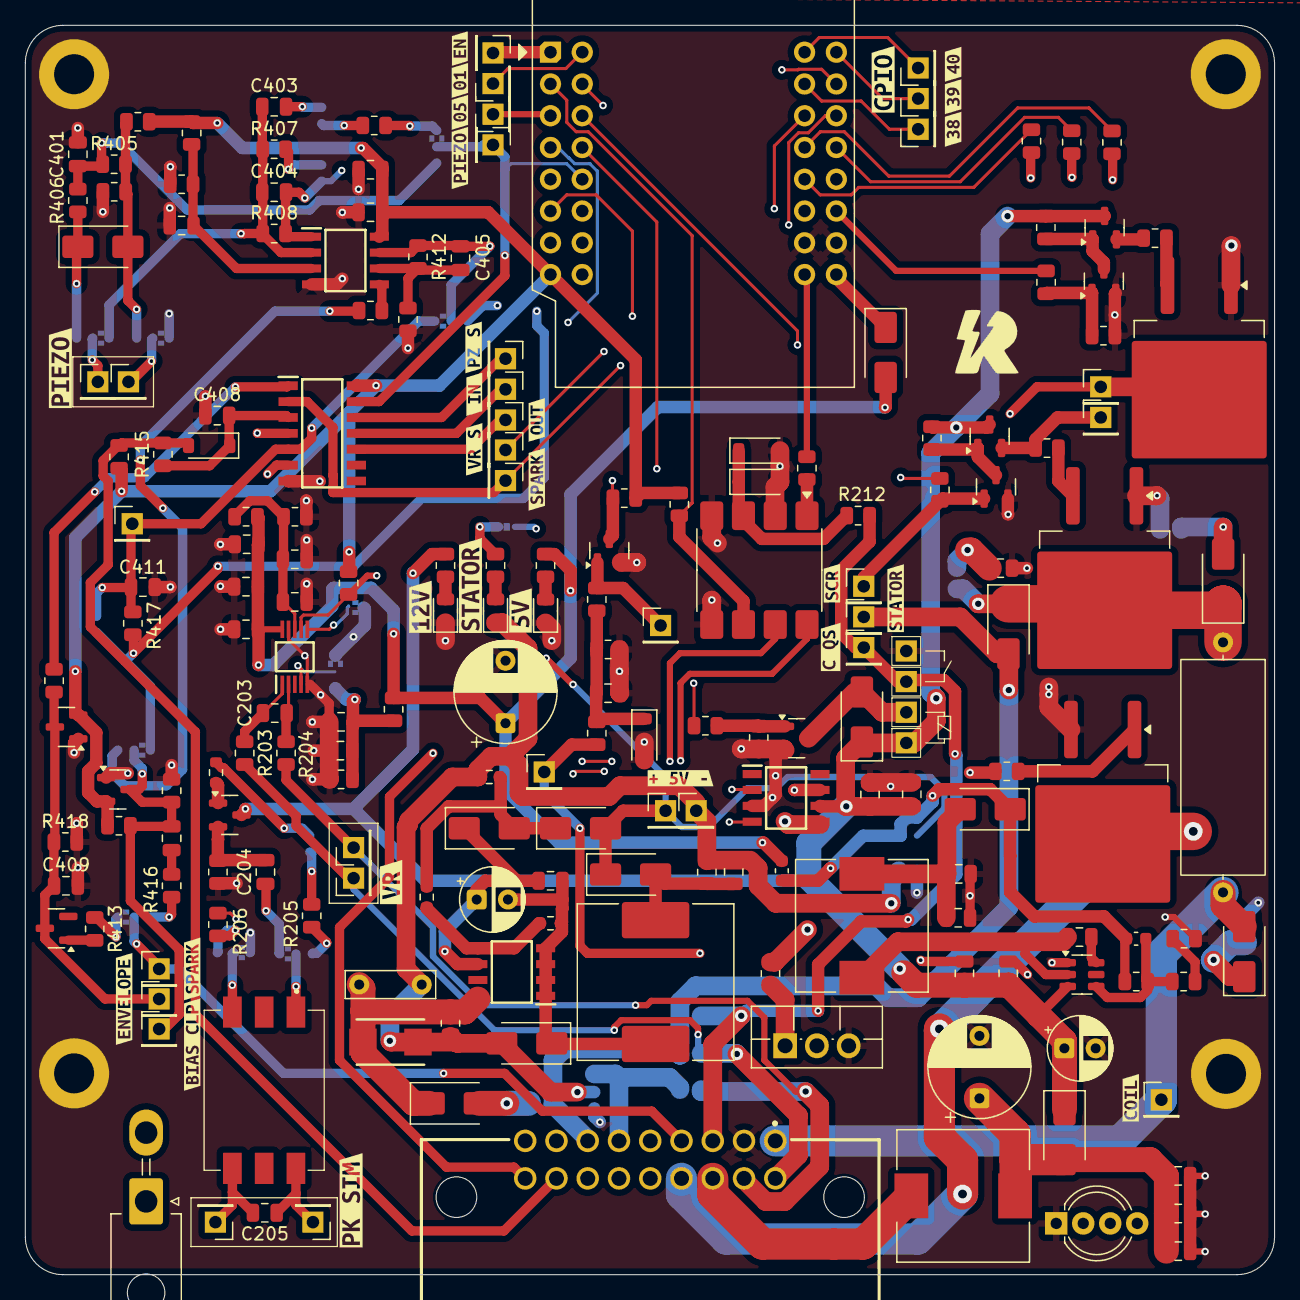
[picture p10: board ecu-dev-board.kicad_pcb from above]

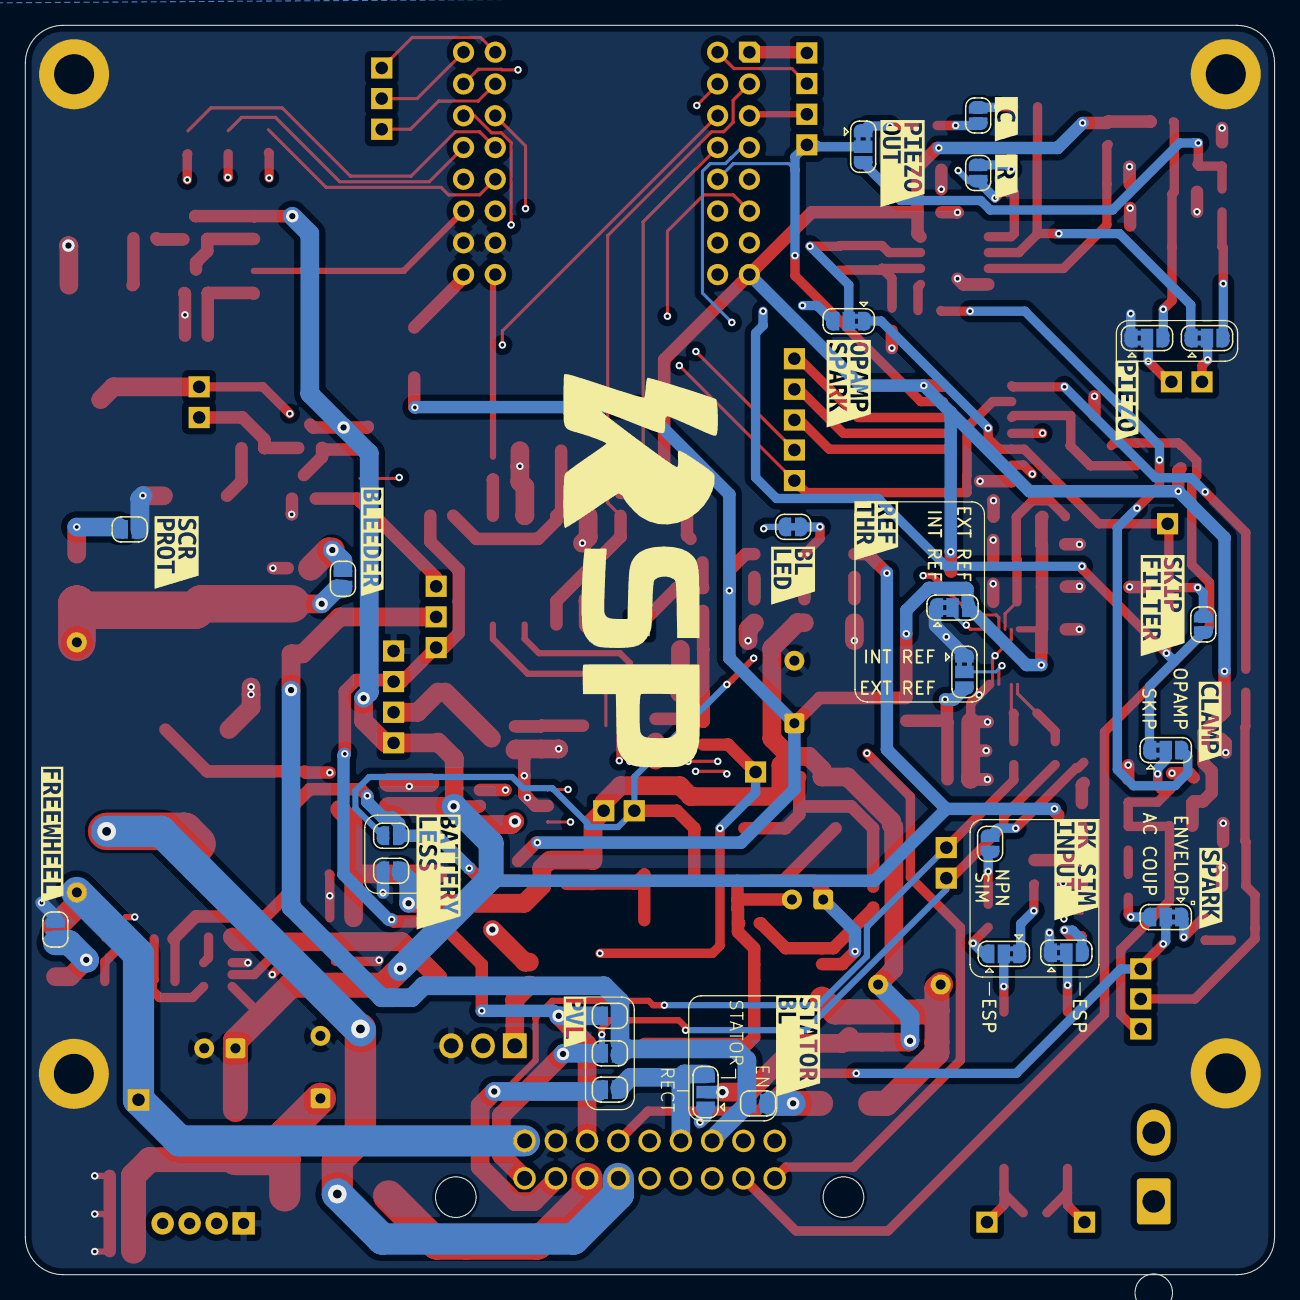
[picture p11: board ecu-dev-board.kicad_pcb from below]

Board: 4 copper layers, 99.9 x 99.9 mm, 263 parts (42 on the bottom side), 133 nets.

Other parts of the board:
D1: SS54; D_SMA
kibuzzard-68DC3BCE: G***; kibuzzard-68DC3BCE
kibuzzard-68DC3C5F: G***; kibuzzard-68DC3C5F
kibuzzard-68DC3C6B: G***; kibuzzard-68DC3C6B
kibuzzard-68DC3C7A: G***; kibuzzard-68DC3C7A
kibuzzard-68DC3E65: G***; kibuzzard-68DC3E65
kibuzzard-68DC356E: G***; kibuzzard-68DC356E
kibuzzard-68DD7CEF: G***; kibuzzard-68DD7CEF
kibuzzard-68DD858B: G***; kibuzzard-68DD858B
kibuzzard-68E56D60: G***; kibuzzard-68E56D60
kibuzzard-68E56FCB: G***; kibuzzard-68E56FCB
kibuzzard-68E56FD6: G***; kibuzzard-68E56FD6
kibuzzard-68E57BA0: G***; kibuzzard-68E57BA0
kibuzzard-68E57C5B: G***; kibuzzard-68E57C5B
kibuzzard-68E57F36: G***; kibuzzard-68E57F36
kibuzzard-68E573FB: G***; kibuzzard-68E573FB
kibuzzard-68E576A7: G***; kibuzzard-68E576A7
kibuzzard-68E576ED: G***; kibuzzard-68E576ED
kibuzzard-68E576F3: G***; kibuzzard-68E576F3
kibuzzard-68E577C0: G***; kibuzzard-68E577C0
kibuzzard-68E577E7: G***; kibuzzard-68E577E7
kibuzzard-68E580F6: G***; kibuzzard-68E580F6
kibuzzard-68E57016: G***; kibuzzard-68E57016
kibuzzard-68E57081: G***; kibuzzard-68E57081
kibuzzard-68E57197: G***; kibuzzard-68E57197
kibuzzard-68E57368: G***; kibuzzard-68E57368
kibuzzard-68E57507: G***; kibuzzard-68E57507
kibuzzard-68E57739: G***; kibuzzard-68E57739
kibuzzard-68E57776: G***; kibuzzard-68E57776
kibuzzard-68E57798: G***; kibuzzard-68E57798
kibuzzard-68EB72B9: G***; kibuzzard-68EB72B9
kibuzzard-68EB72C7: G***; kibuzzard-68EB72C7
kibuzzard-68EB72CC: G***; kibuzzard-68EB72CC
kibuzzard-68EB72E2: G***; kibuzzard-68EB72E2
kibuzzard-68EB72EA: G***; kibuzzard-68EB72EA
kibuzzard-68EB72EE: G***; kibuzzard-68EB72EE
kibuzzard-68EB72F2: G***; kibuzzard-68EB72F2
kibuzzard-68EB73A6: G***; kibuzzard-68EB73A6
kibuzzard-68EB732B: G***; kibuzzard-68EB732B
kibuzzard-68EB733C: G***; kibuzzard-68EB733C
kibuzzard-68EB7325: G***; kibuzzard-68EB7325
kibuzzard-68EB7336: G***; kibuzzard-68EB7336
kibuzzard-68EB7341: G***; kibuzzard-68EB7341
kibuzzard-68EB7408: G***; kibuzzard-68EB7408
kibuzzard-68EB7423: G***; kibuzzard-68EB7423

Their connections:
+5V: D1.2 (A); also elsewhere on the board
