D3stan/ecu-dev-board/code/src/StorageHandler.cpp

#include "StorageHandler.hpp"

StorageHandler::StorageHandler()
    : _initialized(false)
{
}

bool StorageHandler::begin() {
    if (!LittleFS.begin(true)) {  // true = format on mount failure
        
        return false;
    }
    
    _initialized = true;
    
    printInfo();
    
    return true;
}

void StorageHandler::getDefaultConfig(SystemConfig& config) {
    // QuickShifter defaults
    config.qsConfig.minRpmThreshold = 3000;
    config.qsConfig.debounceTimeMs = 50;
    for (auto& cutTime : config.qsConfig.cutTimeMap) {
        cutTime = 80;  // 80ms default for all RPM ranges
    }
    
    // Network defaults
    strcpy(config.networkConfig.apSsid, "rspqs");
    config.networkConfig.apPassword[0] = '\0';  // Empty password for AP
    config.networkConfig.staSsid[0] = '\0';     // Empty STA SSID
    config.networkConfig.staPassword[0] = '\0'; // Empty STA password
    config.networkConfig.staMode = false;  // Start in AP mode
    config.networkConfig.lastError[0] = '\0';  // No error
    
    // Telemetry defaults
    config.telemetryConfig.updateRateMs = 100;
}

bool StorageHandler::loadConfig(SystemConfig& config) {
    if (!_initialized) {
        
        getDefaultConfig(config);
        return false;
    }
    
    File file = LittleFS.open(CONFIG_FILE, "r");
    if (!file) {
        
        getDefaultConfig(config);
        return false;
    }
    
    // Read file content
    size_t size = file.size();
    if (size == 0 || size > 2048) {
        
        file.close();
        getDefaultConfig(config);
        return false;
    }
    
    // Parse JSON with fixed-size buffer
    StaticJsonDocument<1024> doc;
    DeserializationError error = deserializeJson(doc, file);
    file.close();
    
    if (error) {
        
        
        getDefaultConfig(config);
        return false;
    }
    
    // Check if document overflowed
    if (doc.overflowed()) {
        
        getDefaultConfig(config);
        doc.clear();
        return false;
    }
    
    // Load QuickShifter config
    config.qsConfig.minRpmThreshold = doc["qs"]["minRpm"] | 3000;
    config.qsConfig.debounceTimeMs = doc["qs"]["debounce"] | 50;
    
    JsonArray cutTimeArray = doc["qs"]["cutTimeMap"];
    if (cutTimeArray.size() == 11) {
        for (size_t i = 0; i < 11; i++) {
            config.qsConfig.cutTimeMap[i] = cutTimeArray[i] | 80;
        }
    } else {
        for (auto& cutTime : config.qsConfig.cutTimeMap) {
            cutTime = 80;
        }
    }
    
    // Load Network config
    strlcpy(config.networkConfig.apSsid, doc["network"]["apSsid"] | "rspqs", sizeof(config.networkConfig.apSsid));
    strlcpy(config.networkConfig.apPassword, doc["network"]["apPassword"] | "", sizeof(config.networkConfig.apPassword));
    strlcpy(config.networkConfig.staSsid, doc["network"]["staSsid"] | "", sizeof(config.networkConfig.staSsid));
    strlcpy(config.networkConfig.staPassword, doc["network"]["staPassword"] | "", sizeof(config.networkConfig.staPassword));
    config.networkConfig.staMode = doc["network"]["staMode"] | false;
    strlcpy(config.networkConfig.lastError, doc["network"]["lastError"] | "", sizeof(config.networkConfig.lastError));
    
    // Load Telemetry config
    config.telemetryConfig.updateRateMs = doc["telemetry"]["updateRate"] | 100;
    doc.clear();
    
    return true;
}

bool StorageHandler::saveConfig(const SystemConfig& config) {
    if (!_initialized) {
        
        return false;
    }
    
    // Create JSON document with fixed size
    StaticJsonDocument<1024> doc;
    
    // QuickShifter config
    JsonObject qs = doc.createNestedObject("qs");
    qs["minRpm"] = config.qsConfig.minRpmThreshold;
    qs["debounce"] = config.qsConfig.debounceTimeMs;
    
    JsonArray cutTimeArray = qs.createNestedArray("cutTimeMap");
    for (const auto& cutTime : config.qsConfig.cutTimeMap) {
        cutTimeArray.add(cutTime);
    }
    
    // Network config
    JsonObject network = doc.createNestedObject("network");
    network["apSsid"] = String(config.networkConfig.apSsid);
    network["apPassword"] = String(config.networkConfig.apPassword);
    network["staSsid"] = String(config.networkConfig.staSsid);
    network["staPassword"] = String(config.networkConfig.staPassword);
    network["staMode"] = config.networkConfig.staMode;
    network["lastError"] = String(config.networkConfig.lastError);
    
    // Telemetry config
    JsonObject telemetry = doc.createNestedObject("telemetry");
    telemetry["updateRate"] = config.telemetryConfig.updateRateMs;
    
    // Check if document overflowed
    if (doc.overflowed()) {
        
        return false;
    }
    
    // Serialize to fixed buffer
    char jsonBuffer[1024];
    size_t jsonSize = serializeJson(doc, jsonBuffer, sizeof(jsonBuffer));
    
    if (jsonSize == 0) {
        
        return false;
    }
    
    if (jsonSize >= sizeof(jsonBuffer)) {
        
        return false;
    }
    
    // Atomic write
    bool success = atomicWrite(CONFIG_FILE, jsonBuffer, jsonSize);
    
    if (success) {
        
    } else {
        
    }
    
    doc.clear();

    return success;
}

bool StorageHandler::loadQsConfig(QuickShifterEngine::Config& config) {
    SystemConfig sysConfig;
    bool result = loadConfig(sysConfig);
    config = sysConfig.qsConfig;
    return result;
}

bool StorageHandler::saveQsConfig(const QuickShifterEngine::Config& config) {
    SystemConfig sysConfig;
    loadConfig(sysConfig);
    sysConfig.qsConfig = config;
    return saveConfig(sysConfig);
}

bool StorageHandler::loadNetworkConfig(NetworkConfig& config) {
    SystemConfig sysConfig;
    bool result = loadConfig(sysConfig);
    config = sysConfig.networkConfig;
    return result;
}

bool StorageHandler::saveNetworkConfig(const NetworkConfig& config) {
    SystemConfig sysConfig;
    loadConfig(sysConfig);
    sysConfig.networkConfig = config;
    return saveConfig(sysConfig);
}

bool StorageHandler::loadTelemetryConfig(TelemetryConfig& config) {
    SystemConfig sysConfig;
    bool result = loadConfig(sysConfig);
    config = sysConfig.telemetryConfig;
    return result;
}

bool StorageHandler::saveTelemetryConfig(const TelemetryConfig& config) {
    SystemConfig sysConfig;
    loadConfig(sysConfig);
    sysConfig.telemetryConfig = config;
    return saveConfig(sysConfig);
}

bool StorageHandler::hasWebInterface() const {
    if (!_initialized) return false;
    return LittleFS.exists(WEB_HTML_FILE);
}

void StorageHandler::printInfo() {
    if (!_initialized) return;
    
    size_t total = LittleFS.totalBytes();
    size_t used = LittleFS.usedBytes();
    
    Serial.printf("[Storage] Total: %d bytes, Used: %d bytes, Free: %d bytes\n", 
                  total, used, total - used);
}

bool StorageHandler::atomicWrite(const char* filename, const char* data, size_t len) {
    // Write to temporary file first
    File tmpFile = LittleFS.open(CONFIG_TEMP_FILE, "w");
    if (!tmpFile) {
        
        return false;
    }
    
    size_t written = tmpFile.write((const uint8_t*)data, len);
    tmpFile.flush();  // Ensure data is written to flash
    tmpFile.close();
    
    if (written != len) {
        
        LittleFS.remove(CONFIG_TEMP_FILE);
        return false;
    }
    
    // Remove old file if exists
    if (LittleFS.exists(filename)) {
        LittleFS.remove(filename);
    }
    
    // Rename temp file to actual filename
    if (!LittleFS.rename(CONFIG_TEMP_FILE, filename)) {
        
        return false;
    }
    
    return true;
}
