D3stan/ecu-dev-board/emulator/main/sim_io_capture.c

/**
 * @file sim_io_capture.c
 * @brief Passive Spark Advance Monitoring & Timing Interrupt Service Routine.
 * 
 * Part of the ECU Simulator Node implementation (Phase 5).
 */

#include <stdio.h>
#include "pins.h"

float sim_io_get_spark_advance(float current_rpm) {
    // Placeholder - to be fully implemented in Phase 5
    return 0.0f;
}
