D3stan/ecu-dev-board/(commit log)

2025-08-30 added pickupsim section
    [ecu-dev-board.kicad_sch]
2025-08-30 added pickupsim section 1
    [Pickup.kicad_sch]
2025-08-30 added footprints to pickup sim
    [Pickup.kicad_sch]
2025-08-30 created MCU sheet
    [Pickup.kicad_sch, ecu-dev-board.kicad_sch]
2025-08-30 created MCU sheet 1
    [MCU.kicad_sch]
2025-08-30 added VR input IC conditioner
    [MCU.kicad_sch, Pickup.kicad_sch]
2025-08-30 added mode selection
    [MCU.kicad_sch, Pickup.kicad_sch]
2025-08-31 added SSR
    [MCU.kicad_sch, Pickup.kicad_sch, Sensor.kicad_sch, ecu-dev-board.kicad_sch]
2025-08-31 added CDI
    [CDI.kicad_sch, Pickup.kicad_sch, Sensor.kicad_sch, ecu-dev-board.kicad_sch]
2025-08-31 small fix
    [CDI.kicad_sch, Sensor.kicad_sch, ecu-dev-board.kicad_sch]
2025-09-01 added spark detection
    [Sensor.kicad_sch]
2025-09-01 added batteryless function
    [MCU.kicad_sch, Pickup.kicad_sch, Powersupply.kicad_sch, Sensor.kicad_sch, ecu-dev-board.kicad_sch]
2025-09-01 minor corrections
    [Powersupply.kicad_sch]
2025-09-01 added production folder for semplicity
    [bom.csv, designators.csv, positions.csv]
2025-09-01 added predisposition for second piezo conditioning circuit
    [Powersupply.kicad_sch, Sensor.kicad_sch]
2025-09-04 video call revision
    [CDI.kicad_sch, Pickup.kicad_sch, Powersupply.kicad_sch, Sensor.kicad_sch]
2025-09-05 added 12 to 5 buck
    [Powersupply.kicad_sch, ecu-dev-board.kicad_sch]
2025-09-05 added reverse polarity protection
    [Powersupply.kicad_sch]
2025-09-05 added TCI quickshifter file
    [TCI.kicad_sch]
2025-09-05 implemented TCI quickshifter
    [TCI.kicad_sch]
2025-09-05 fixed IGBT logic
    [TCI.kicad_sch]
2025-09-05 added footprints
    [CDI.kicad_sch, Pickup.kicad_sch, Powersupply.kicad_sch, Sensor.kicad_sch, TCI.kicad_sch]
2025-09-15 added SCR from kill switch to GND and RGB led
    [CDI.kicad_sch, MCU.kicad_sch, Sensor.kicad_sch]
2025-09-15 added digital input for QS
    [MCU.kicad_sch, Sensor.kicad_sch]
2025-09-15 fixed basic pcb errors
    [MCU.kicad_sch, Powersupply.kicad_sch, Sensor.kicad_sch, bom.csv, designators.csv, positions.csv]
2025-09-16 added connector and simulation link
    [CDI.kicad_sch, MCU.kicad_sch, Pickup.kicad_sch, Powersupply.kicad_sch, ecu-dev-board.kicad_sch]
2025-09-16 added more connector tags
    [MCU.kicad_sch, ecu-dev-board.kicad_sch]
2025-09-16 enhanced pickup simulation
    [MCU.kicad_sch, Pickup.kicad_sch, Sensor.kicad_sch, ecu-dev-board.kicad_sch]
2025-09-16 changed capacitors and resistors footprints from 0201 to 0603
    [CDI.kicad_sch, MCU.kicad_sch, Pickup.kicad_sch, Powersupply.kicad_sch, Sensor.kicad_sch, TCI.kicad_sch, bom.csv, designators.csv]
2025-09-17 changed SCR drives to pnp drive and started schematic revision
    [CDI.kicad_sch, MCU.kicad_sch, Pickup.kicad_sch, Powersupply.kicad_sch, Sensor.kicad_sch, bom.csv, ecu-dev-board.kicad_sch]
2025-09-17 External voltage reference of the MAX9924 is now a voltage divider and not the ESP32 PWM anymore
    [Pickup.kicad_sch]
2025-09-17 removed mode A1 from MAX9924 configuration
    [Pickup.kicad_sch]
2025-09-17 simplified pickup simulation pinout
    [MCU.kicad_sch, Pickup.kicad_sch]
2025-09-20 completed photomos revision
    [CDI.kicad_sch, Pickup.kicad_sch]
2025-09-20 changed the QS cut to use a relay
    [CDI.kicad_sch]
2025-09-20 fixed reverse polarity protection
    [CDI.kicad_sch, Powersupply.kicad_sch]
2025-09-20 added proper handling and comments to QS digital sensor
    [MCU.kicad_sch, Powersupply.kicad_sch, Sensor.kicad_sch]
2025-09-22 changed R and C to standard values
    [Powersupply.kicad_sch]
2025-09-22 added more stable output feedback to the ACDC converter
    [Powersupply.kicad_sch]
2025-09-22 enhanced spark detection circuit
    [MCU.kicad_sch, Sensor.kicad_sch]
2025-09-23 improved opamp charge amplifier
    [Sensor.kicad_sch]
2025-09-23 widely changed TCI schematic to use a FET IC driver
    [MCU.kicad_sch, TCI.kicad_sch]
2025-09-23 removed small schematic error
    [CDI.kicad_sch]
2025-09-23 change some resistor footprints to 0.25W compatible
    [Powersupply.kicad_sch]
2025-09-23 added more test points
    [TCI.kicad_sch]
2025-09-23 added PSU status LEDs and stator winding support
    [Powersupply.kicad_sch, ecu-dev-board.kicad_sch]
2025-09-23 fixed LEDs footprints
    [Powersupply.kicad_sch, Sensor.kicad_sch]
2025-09-23 fixed pcb import errors
    [Powersupply.kicad_sch, Sensor.kicad_sch]
2025-09-23 added custom footprint for external relay
    [CDI.kicad_sch, Sensor.kicad_sch, bom.csv, designators.csv, positions.csv]
2025-09-23 changed photomos footprint to match datasheet
    [Pickup.kicad_sch, ecu-dev-board.kicad_pcb]
2025-09-23 updated inductance footprints
    [Powersupply.kicad_sch, ecu-dev-board.kicad_pcb]
2025-09-24 added DNP for fabrication and 2P molex connector, minor fixes
    [CDI.kicad_sch, MCU.kicad_sch, Pickup.kicad_sch, Powersupply.kicad_sch, Sensor.kicad_sch, TCI.kicad_sch, ecu-dev-board.kicad_pcb, ecu-dev-board.kicad_sch]
2025-09-24 added 3D models for connectors and MCU
    [ecu-dev-board.kicad_pcb]
2025-09-24 initiated PCB modelling
    [ecu-dev-board.kicad_pcb]
2025-09-25 added another CDI output sensing (opto coupler)
    [MCU.kicad_sch, Pickup.kicad_sch, Sensor.kicad_sch, ecu-dev-board.kicad_sch]
2025-09-25 changed to THT footprint for better analysis
    [Pickup.kicad_sch]
2025-09-25 removed unnecessary jumpers
    [Pickup.kicad_sch]
2025-09-25 made some re-routing to reduce EMI
    [ecu-dev-board.kicad_sch]
2025-09-25 added pull-downs to QS stuff
    [CDI.kicad_sch, MCU.kicad_sch]
2025-09-25 MCU labels rework
    [MCU.kicad_sch, Pickup.kicad_sch, ecu-dev-board.kicad_sch]
2025-09-25 removed GNDPWR
    [CDI.kicad_sch, Powersupply.kicad_sch, ecu-dev-board.kicad_sch]
2025-09-25 fixed 3.3 and 3V3
    [Powersupply.kicad_sch, Sensor.kicad_sch]
2025-09-25 added schottky OR-ing to DC converters
    [Powersupply.kicad_sch]
2025-09-25 moved the bulk cap outside
    [Powersupply.kicad_sch]
2025-09-25 more minor fixes
    [Powersupply.kicad_sch]
2025-09-25 changed zener footprints
    [Pickup.kicad_sch, TCI.kicad_sch]
2025-09-25 added PVL ignitions support
    [Pickup.kicad_sch, ecu-dev-board.kicad_pcb]
2025-09-25 added notes
    [ecu-dev-board.kicad_pcb]
2025-09-25 changed THT to SMD for both resistors and capacitors since they will be replaced by hand with soldering tweezers
    [CDI.kicad_sch, Pickup.kicad_sch, Sensor.kicad_sch, ecu-dev-board.kicad_pcb]
2025-09-25 updated SCRs footprint
    [CDI.kicad_sch]
2025-09-25 added ideal maximum board size
    [TCI.kicad_sch, ecu-dev-board.kicad_pcb]
2025-09-25 organized pcb
    [ecu-dev-board.kicad_pcb]
2025-09-25 ordered jumpers and test pins
    [ecu-dev-board.kicad_pcb]
2025-09-26 revision 2.0: added LC Vbatt filtering and changed Pmos protection to be a schttoky
    [Powersupply.kicad_sch, TCI.kicad_sch, ecu-dev-board.kicad_pcb, ecu-dev-board.kicad_sch]
2025-09-26 revision 2.0: changed components numeration
    [CDI.kicad_sch, MCU.kicad_sch, Pickup.kicad_sch, Powersupply.kicad_sch, Sensor.kicad_sch, TCI.kicad_sch, ecu-dev-board.kicad_sch]
2025-09-26 revision 2.0: changed R and C footprints to 0805 (imperial)
    [CDI.kicad_sch, MCU.kicad_sch, Pickup.kicad_sch, Powersupply.kicad_sch, Sensor.kicad_sch, TCI.kicad_sch]
2025-09-26 revision 2.0: other minor changed
    [Powersupply.kicad_sch, ecu-dev-board.kicad_pcb]
2025-09-27 revision 2.0: changed 47uF footprint
    [Powersupply.kicad_sch]
2025-09-27 pcb first iteration of power implementation
    [Powersupply.kicad_sch, ecu-dev-board.kicad_pcb]
2025-09-27 moved ac-dc converter
    [ecu-dev-board.kicad_pcb, ecu-dev-board.kicad_sch]
2025-09-29 placed CDI components
    [ecu-dev-board.kicad_pcb]
2025-09-29 removed duplicated test points
    [Pickup.kicad_sch]
2025-09-29 started analogue and signal digital part
    [ecu-dev-board.kicad_pcb]
2025-09-30 VR conditioning placement
    [ecu-dev-board.kicad_pcb]
2025-09-30 finished pickup and MCU sheets
    [ecu-dev-board.kicad_pcb]
2025-09-30 completed PSU sheet
    [ecu-dev-board.kicad_pcb]
2025-09-30 rounded PCB edges and modified color
    [ecu-dev-board.kicad_pcb]
2025-09-30 completed TCI sheet placement
    [ecu-dev-board.kicad_pcb]
2025-10-01 placed all components inside the boards
    [ecu-dev-board.kicad_pcb]
2025-10-07 added labels
    [ecu-dev-board.kicad_pcb]
2025-10-07 fixed main connector not positioned
    [ecu-dev-board.kicad_pcb]
2025-10-07 small cap value
    [Powersupply.kicad_sch, designators.csv, positions.csv]
2025-10-08 changed battery pin with coil qs
    [ecu-dev-board.kicad_pcb, ecu-dev-board.kicad_sch]
2025-10-08 routed 5V
    [ecu-dev-board.kicad_pcb]
2025-10-08 routed 12V
    [ecu-dev-board.kicad_pcb]
2025-10-08 routed 3V3
    [ecu-dev-board.kicad_pcb]
2025-10-08 power aux connections
    [ecu-dev-board.kicad_pcb]
2025-10-08 routed batteryless from statort
    [ecu-dev-board.kicad_pcb]
2025-10-08 routed stator and CDI
    [ecu-dev-board.kicad_pcb]
2025-10-08 made some traces bigger and routed partially the TCI
    [ecu-dev-board.kicad_pcb]
2025-10-08 added bigger vias
    [ecu-dev-board.kicad_pcb]
2025-10-09 started components grounding using vias
    [ecu-dev-board.kicad_pcb]
2025-10-09 completed components grounding using vias
    [ecu-dev-board.kicad_pcb]
2025-10-09 routed OPAMP and Schmitt Trigger
    [ecu-dev-board.kicad_pcb]
2025-10-09 routed GPIOs
    [ecu-dev-board.kicad_pcb]
2025-10-09 fixed DRC errors
    [ecu-dev-board.kicad_pcb]
2025-10-09 components updates
    [MCU.kicad_sch, Pickup.kicad_sch, Powersupply.kicad_sch, Sensor.kicad_sch, bom.csv, designators.csv, ecu-dev-board.kicad_pcb, positions.csv]
2025-10-09 minor fixes
    [Powersupply.kicad_sch]
2025-10-12 swapped ADC with digital pins
    [MCU.kicad_sch, ecu-dev-board.kicad_pcb]
2025-10-13 removed unnecessary silkscreen designators
    [Pickup.kicad_sch, Sensor.kicad_sch, TCI.kicad_sch, bom.csv, designators.csv, ecu-dev-board.kicad_pcb]
2025-10-13 modified pickup sim jumpers
    [Pickup.kicad_sch, ecu-dev-board.kicad_pcb]
2025-10-13 modified VR conditioner jumpers
    [Pickup.kicad_sch, ecu-dev-board.kicad_pcb]
2025-10-13 modified BL led jumper
    [Powersupply.kicad_sch, ecu-dev-board.kicad_pcb]
2025-10-13 modified sensors jumpers
    [Sensor.kicad_sch, ecu-dev-board.kicad_pcb]
2025-10-14 added logos
    [ecu-dev-board.kicad_pcb]
2025-10-14 added diode to prevent backfeed from USB VBUS to 5V
    [MCU.kicad_sch, bom.csv, designators.csv, ecu-dev-board.kicad_pcb, positions.csv]
2025-10-14 moved holes
    [ecu-dev-board.kicad_pcb]
2025-10-15 added GND planes
    [ecu-dev-board.kicad_pcb]
2025-10-28 pin mapping
2025-10-29 board test: RGB led and pickup simulator
2025-10-29 board test: VR input bench test
2025-10-30 board test: PIEZO bench and static bike test
2025-11-17 created first enclosure
    [Enclosure.step]
2025-11-17 removed large pcb 3D model
2025-12-03 3d models
    [Enclosure.step]
2025-12-04 added testing comments
    [CDI.kicad_sch, MCU.kicad_sch, Pickup.kicad_sch, Sensor.kicad_sch]
2025-12-10 solved printf crashes
2025-12-11 ota tries
    [partitions.csv]
2025-12-11 added rpm filtering
2026-06-10 added esp32-s2 pins
2026-06-11 tried fixing ws and adc
    [sim_io_outputs.c, sim_net.c, web_builder.py]
2026-06-11 working adc (tps, not egt)
2026-06-11 fixed egt reading, added ws logging
    [main.c, sim_io_outputs.c, sim_state.h]
2026-06-12 pivoted from DAC to PWM for TPS
2026-06-12 docs: fix 6 classDiagrams + 1 graph in oop_architecture.md (type aliases: BreakpointArray/Span, CharArray16, OptionalEngineEvent, MapSetArray etc; stereotypes <<value_object>> <<trivially_copyable>> 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
2026-06-12 docs: fix last 2 Mermaid diagrams (InputNumber flow -> valid graph TD with quoted labels; webui-conversion phase graph minor), convert 6 callouts in conversion-plan, normalize top links
2026-06-13 added sensors specifications
2026-06-14 added sensors OOP design
2026-06-14 completed sensors analysis
2026-06-14 implemented OOP architecture for sensors acquisition
2026-06-14 major refactoring for sensors macro-area
